MrElliwood/iceduino/docs/iceduino_front_raytraced.png

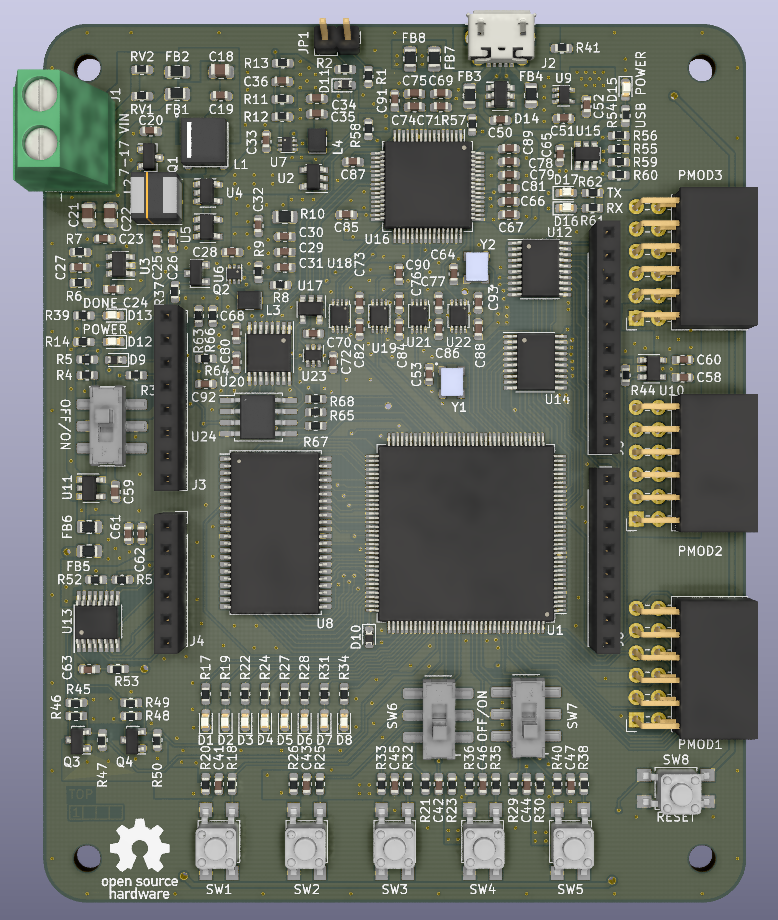
docs/iceduino_front_raytraced.png
