MrElliwood/iceduino/docs/iceduino_iso.png

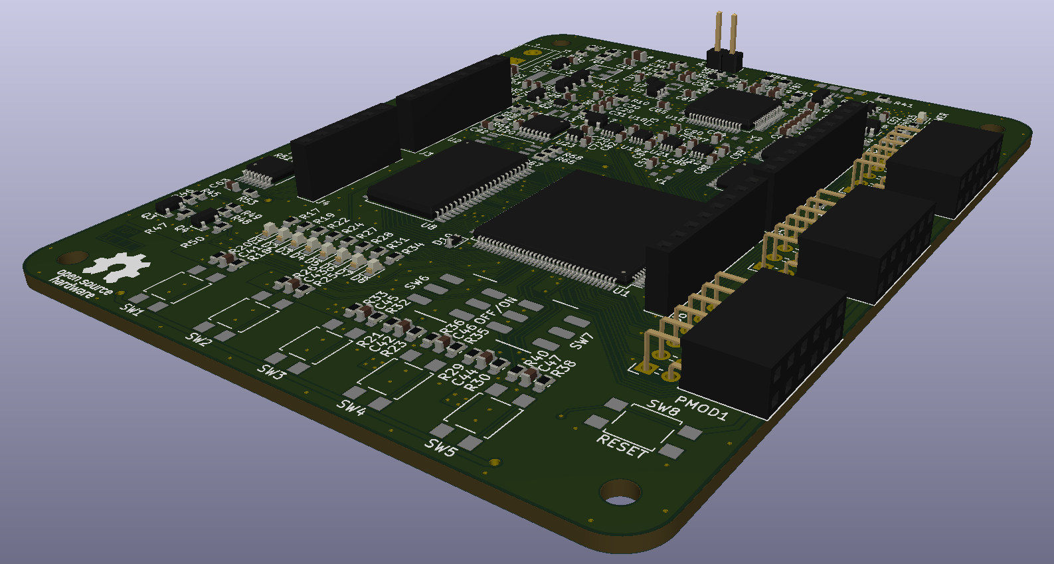
docs/iceduino_iso.png
