MrElliwood/iceduino/docs/iceduino_back.png

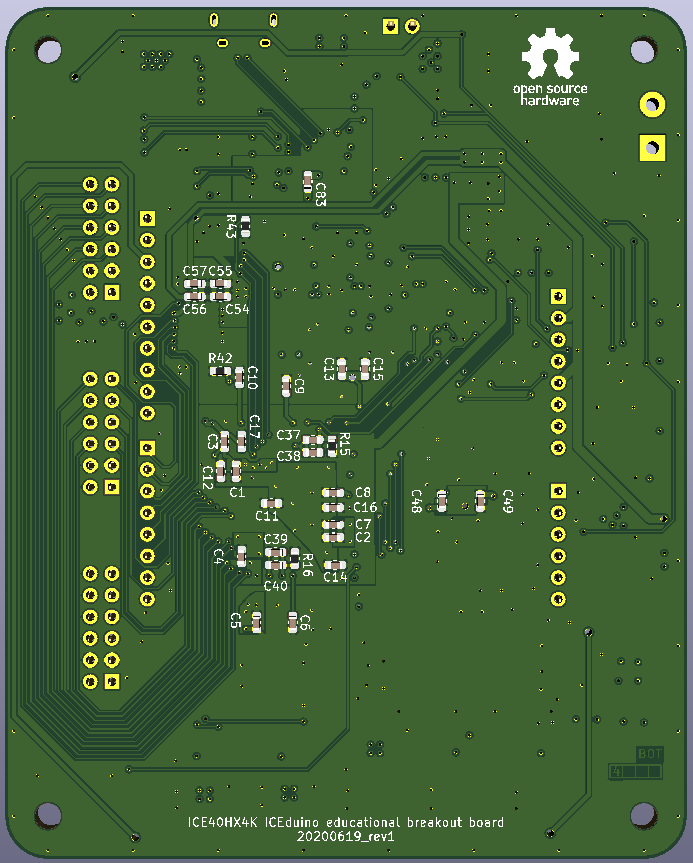
docs/iceduino_back.png
