MrElliwood/iceduino/docs/iceduino_front.png

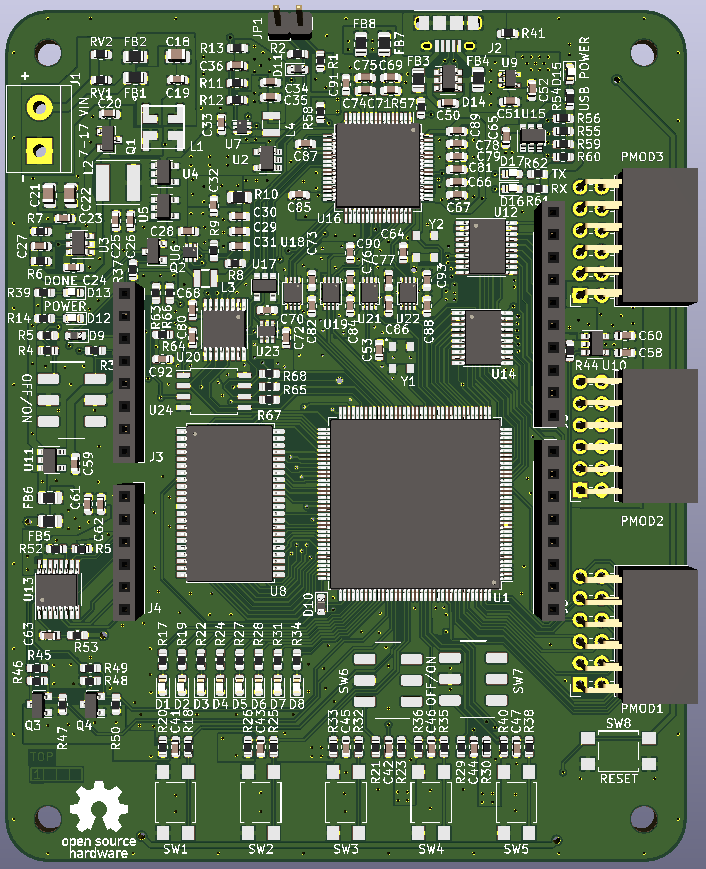
docs/iceduino_front.png
