MrElliwood/iceduino/docs/iceduino-B_SilkS.pdf

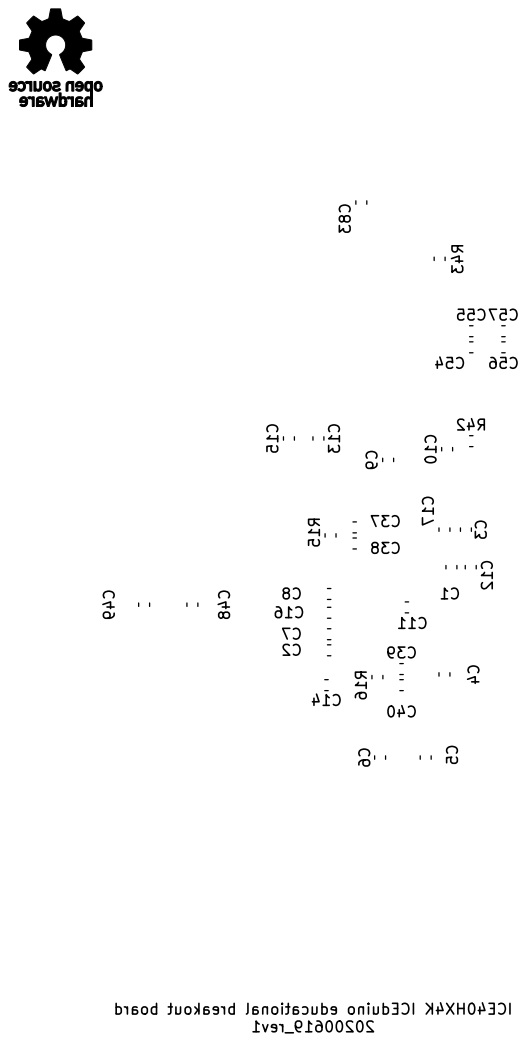
[picture p5: page 1]

ICE40HX4K ICEduino educational breakout board
