MrElliwood/iceduino/docs/iceduino-F_SilkS.pdf

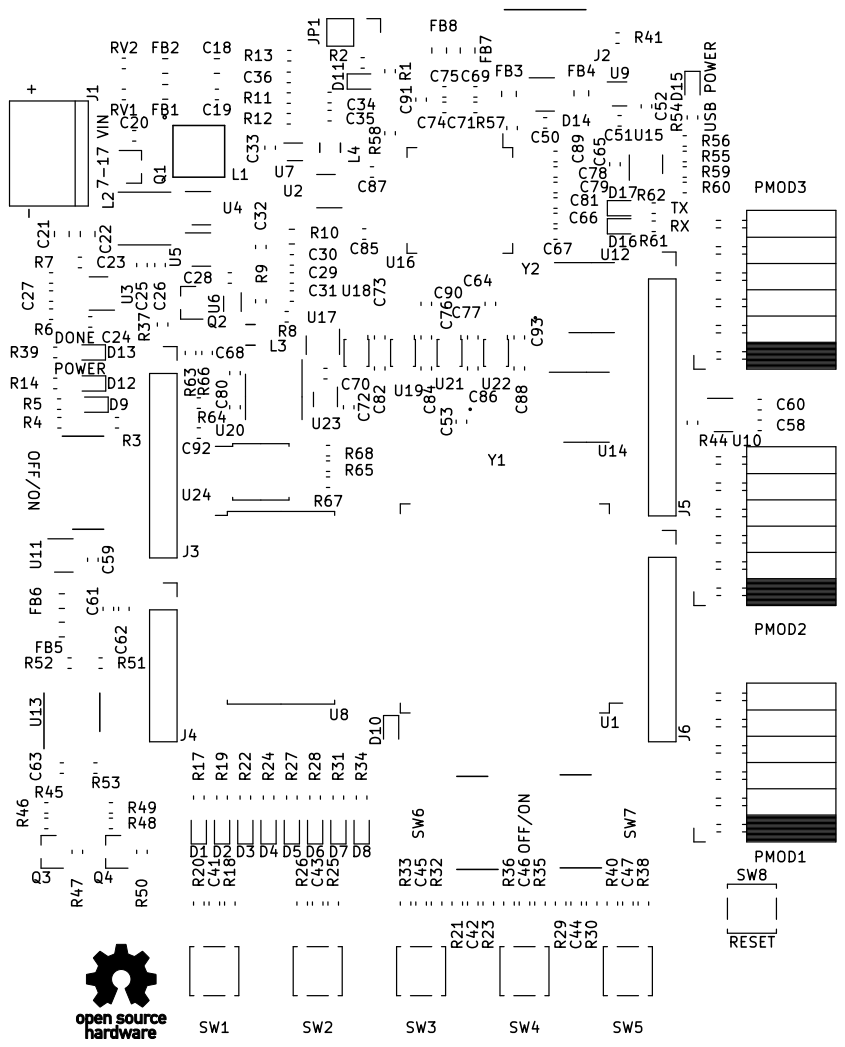
[picture p6: page 1]

OFF/ON USB POWER
RESET RX
