MrElliwood/iceduino/docs/iceduino-B_Cu.pdf

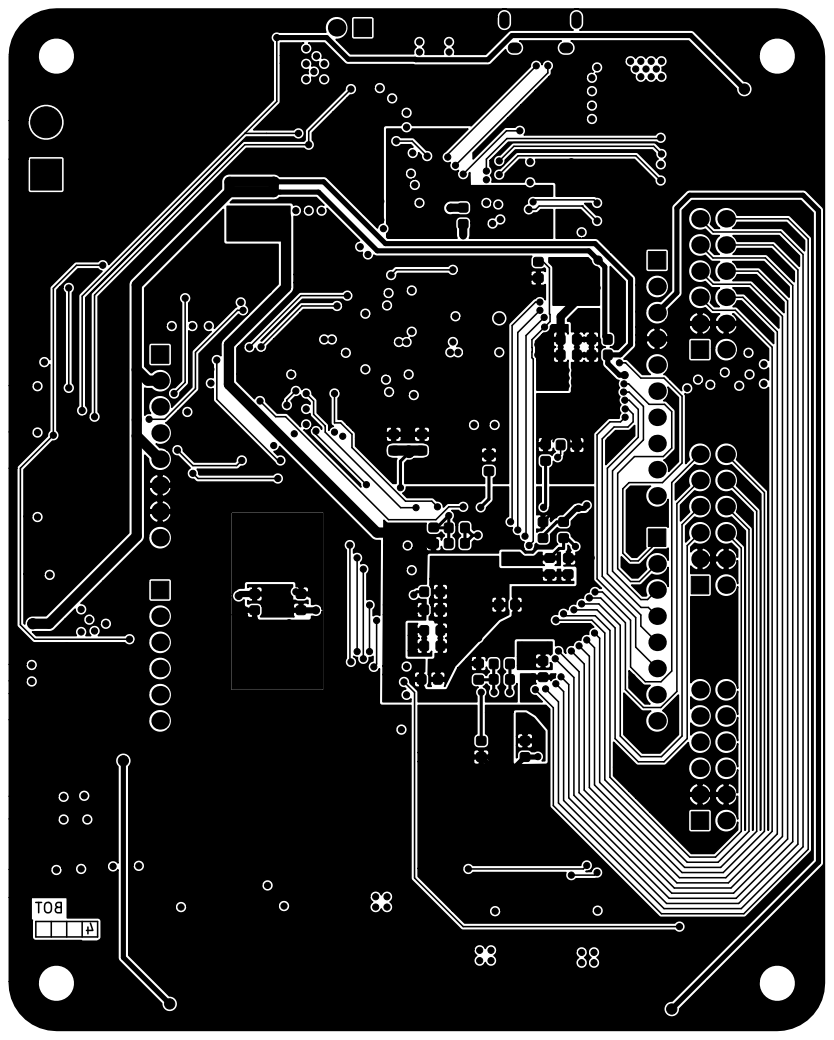
[picture p21: page 1]
