MrElliwood/iceduino/docs/iceduino-F_Cu.pdf

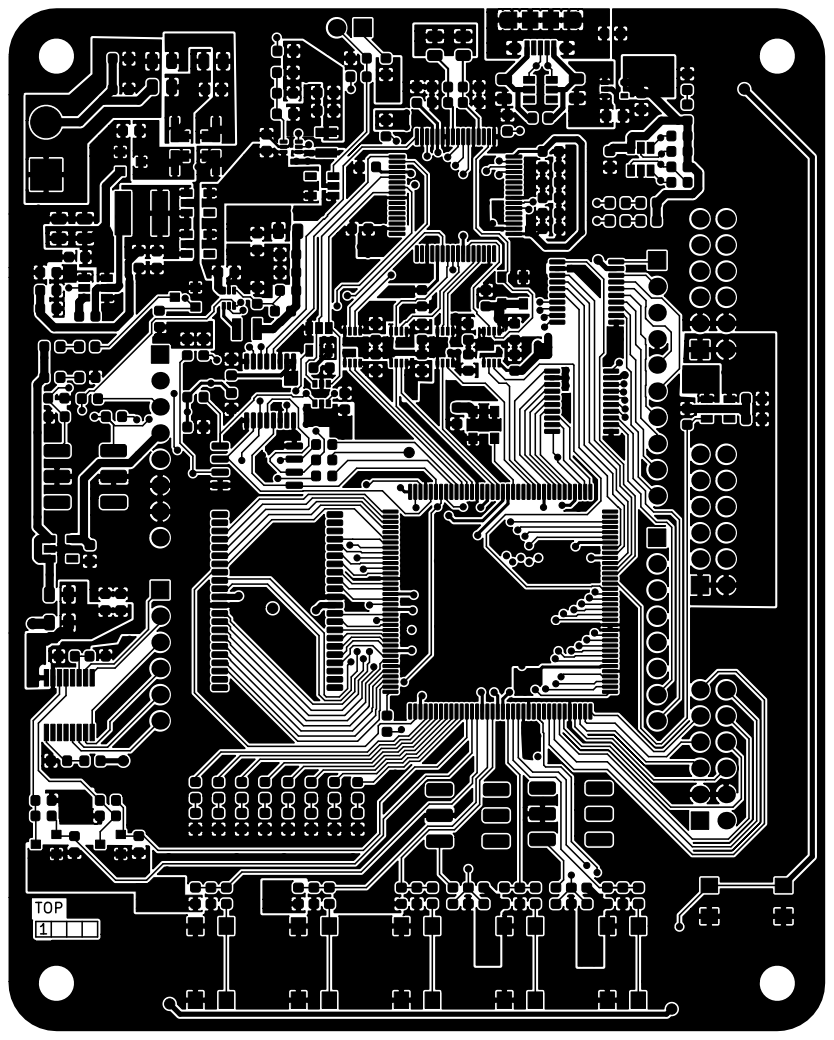
[picture p22: page 1]
