MrElliwood/iceduino/docs/iceduino-In1_Cu.pdf

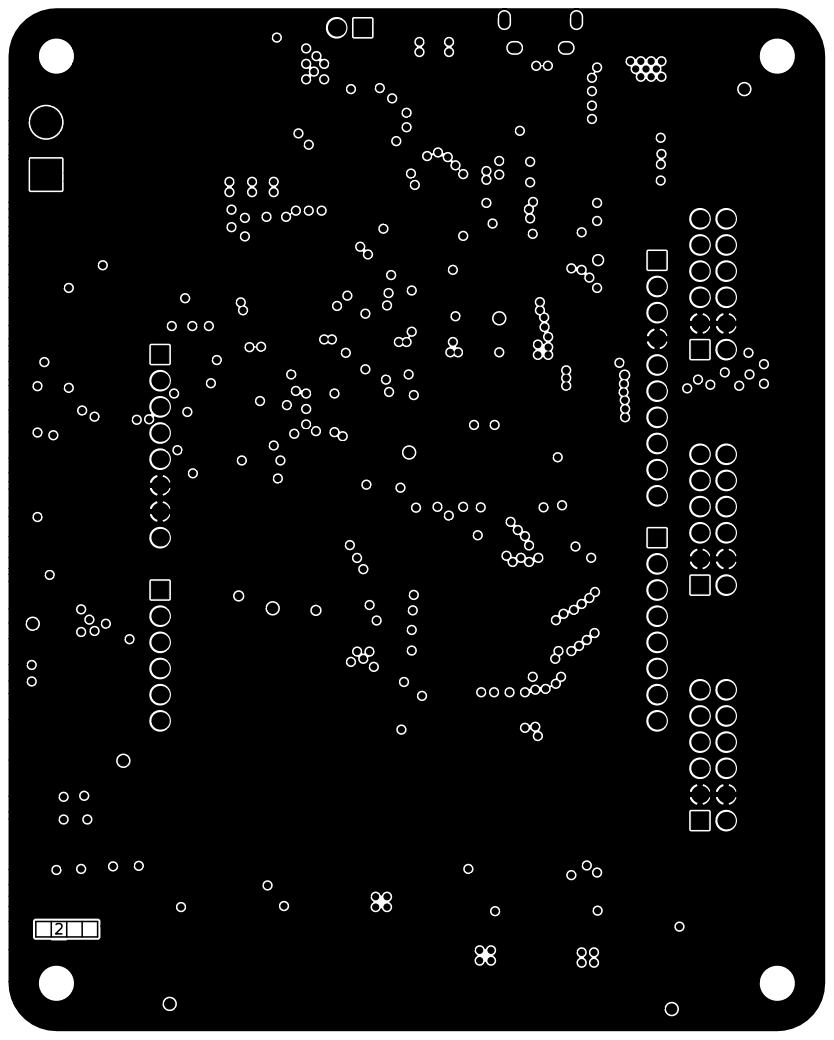
[picture p23: page 1]
