MrElliwood/iceduino/docs/iceduino-In2_Cu.pdf

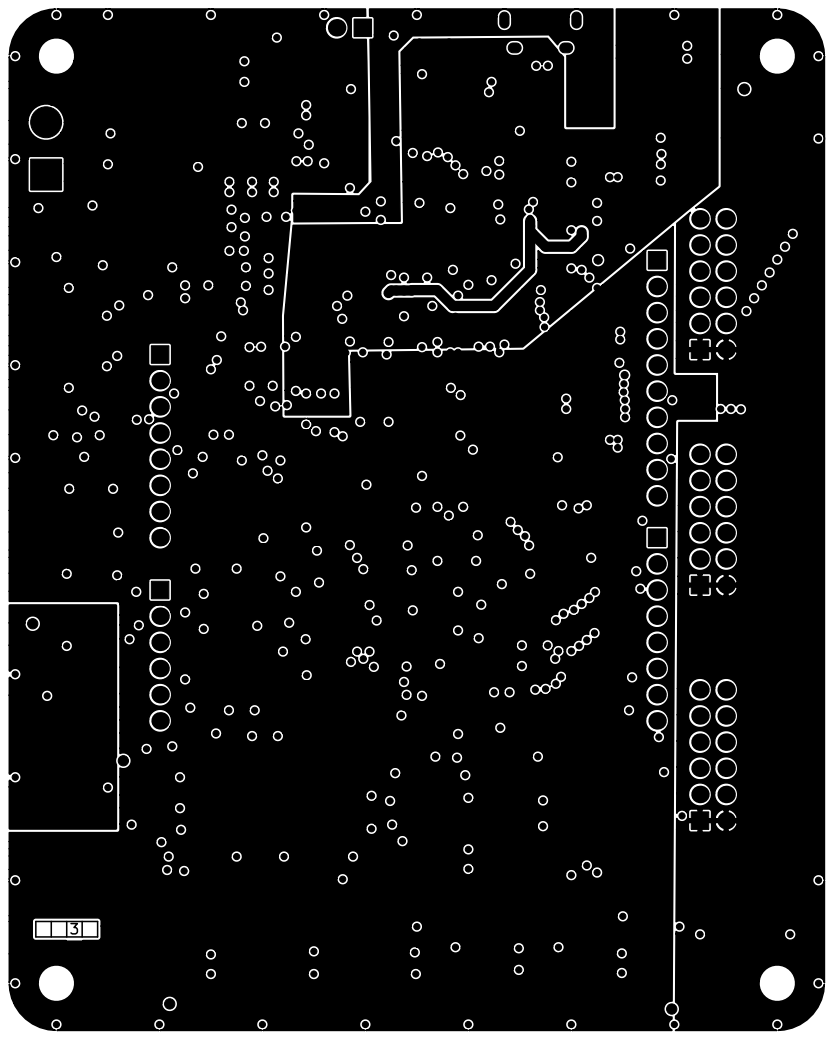
[picture p24: page 1]
