MrElliwood/iceduino/iceduino.kicad_pcb

## KiCad design iceduino.kicad_pcb (2020-06-19)

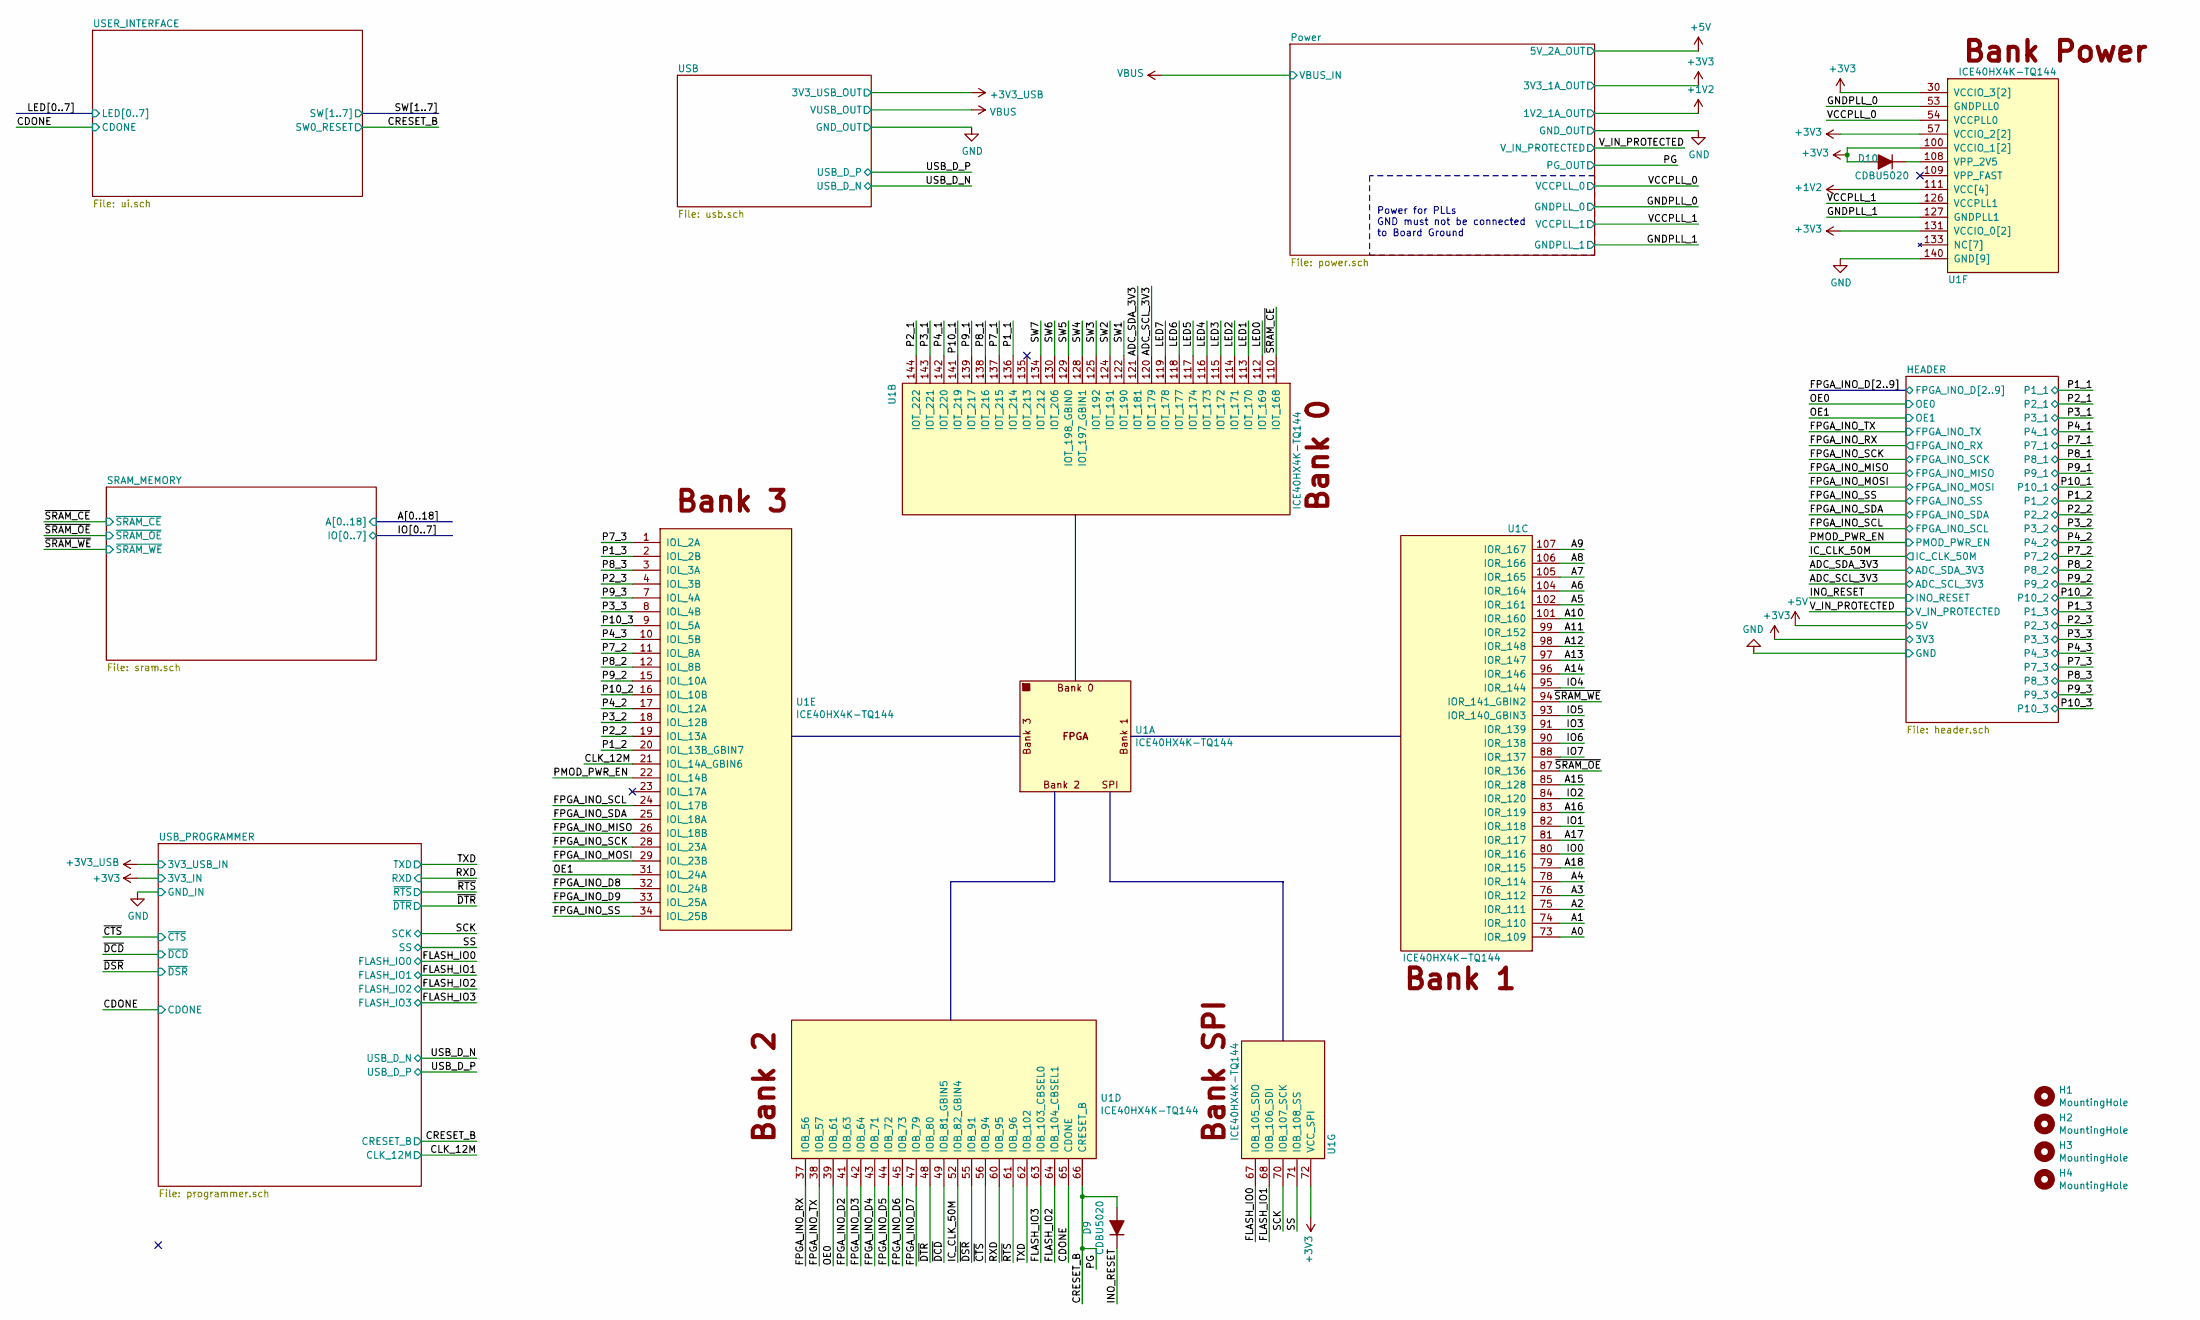
[picture p25: schematic iceduino.sch, ICE40HX4K ICEduino educational breakout board]

Parts:
D9, D10: CDBU5020; D_0603_1608Metric; Mfg Part Num CDBU0520; Digikey 641-1332-1-ND
H1, H2, H3, H4: MountingHole; MountingHole_3mm
U1: ICE40HX4K-TQ144; TQFP-144_20x20mm_P0.5mm; Mfg Part Num ICE40HX4K-TQ144; Digikey 220-1572-ND

Connections:
+1V2: U1.27 (VCC), U1.40 (VCC), U1.92 (VCC), U1.111 (VCC[4]); also elsewhere on the board
+3V3: D10.2 (A), U1.6 (VCCIO_3), U1.30 (VCCIO_3[2]), U1.46 (VCCIO_2), U1.57 (VCCIO_2[2]), U1.72 (VCC_SPI), U1.89 (VCCIO_1), U1.100 (VCCIO_1[2]), U1.123 (VCCIO_0), U1.131 (VCCIO_0[2]); also elsewhere on the board
/A0: U1.73 (IOR_109); also elsewhere on the board
/A1: U1.74 (IOR_110); also elsewhere on the board
/A2: U1.75 (IOR_111); also elsewhere on the board
/A3: U1.76 (IOR_112); also elsewhere on the board
/A4: U1.78 (IOR_114); also elsewhere on the board
/A5: U1.102 (IOR_161); also elsewhere on the board
/A6: U1.104 (IOR_164); also elsewhere on the board
/A7: U1.105 (IOR_165); also elsewhere on the board
/A8: U1.106 (IOR_166); also elsewhere on the board
/A9: U1.107 (IOR_167); also elsewhere on the board
/A10: U1.101 (IOR_160); also elsewhere on the board
/A11: U1.99 (IOR_152); also elsewhere on the board
/A12: U1.98 (IOR_148); also elsewhere on the board
/A13: U1.97 (IOR_147); also elsewhere on the board
/A14: U1.96 (IOR_146); also elsewhere on the board
/A15: U1.85 (IOR_128); also elsewhere on the board
/A16: U1.83 (IOR_119); also elsewhere on the board
/A17: U1.81 (IOR_117); also elsewhere on the board
/A18: U1.79 (IOR_115); also elsewhere on the board
/ADC_SCL_3V3: U1.120 (IOT_179); also elsewhere on the board
/ADC_SDA_3V3: U1.121 (IOT_181); also elsewhere on the board
/CDONE: U1.65 (CDONE); also elsewhere on the board
/CLK_12M: U1.21 (IOL_14A_GBIN6); also elsewhere on the board
/CRESET_B: D9.2 (A), U1.66 (CRESET_B); also elsewhere on the board
/FLASH_IO0: U1.67 (IOB_105_SDO); also elsewhere on the board
/FLASH_IO1: U1.68 (IOB_106_SDI); also elsewhere on the board
/FLASH_IO2: U1.64 (IOB_104_CBSEL1); also elsewhere on the board
/FLASH_IO3: U1.63 (IOB_103_CBSEL0); also elsewhere on the board
/FPGA_INO_D2: U1.41 (IOB_63); also elsewhere on the board
/FPGA_INO_D3: U1.42 (IOB_64); also elsewhere on the board
/FPGA_INO_D4: U1.43 (IOB_71); also elsewhere on the board
/FPGA_INO_D5: U1.44 (IOB_72); also elsewhere on the board
/FPGA_INO_D6: U1.45 (IOB_73); also elsewhere on the board
/FPGA_INO_D7: U1.47 (IOB_79); also elsewhere on the board
/FPGA_INO_D8: U1.32 (IOL_24B); also elsewhere on the board
/FPGA_INO_D9: U1.33 (IOL_25A); also elsewhere on the board
/FPGA_INO_MISO: U1.26 (IOL_18B); also elsewhere on the board
/FPGA_INO_MOSI: U1.29 (IOL_23B); also elsewhere on the board
/FPGA_INO_RX: U1.37 (IOB_56); also elsewhere on the board
/FPGA_INO_SCK: U1.28 (IOL_23A); also elsewhere on the board
/FPGA_INO_SCL: U1.24 (IOL_17B); also elsewhere on the board
/FPGA_INO_SDA: U1.25 (IOL_18A); also elsewhere on the board
/FPGA_INO_SS: U1.34 (IOL_25B); also elsewhere on the board
/FPGA_INO_TX: U1.38 (IOB_57); also elsewhere on the board
/GNDPLL_0: U1.53 (GNDPLL0); also elsewhere on the board
/GNDPLL_1: U1.127 (GNDPLL1); also elsewhere on the board
/IC_CLK_50M: U1.52 (IOB_82_GBIN4); also elsewhere on the board
/INO_RESET: D9.1 (K); also elsewhere on the board
/IO0: U1.80 (IOR_116); also elsewhere on the board
/IO1: U1.82 (IOR_118); also elsewhere on the board
/IO2: U1.84 (IOR_120); also elsewhere on the board
/IO3: U1.91 (IOR_139); also elsewhere on the board
/IO4: U1.95 (IOR_144); also elsewhere on the board
/IO5: U1.93 (IOR_140_GBIN3); also elsewhere on the board
/IO6: U1.90 (IOR_138); also elsewhere on the board
/IO7: U1.88 (IOR_137); also elsewhere on the board
/LED0: U1.112 (IOT_169); also elsewhere on the board
/LED1: U1.113 (IOT_170); also elsewhere on the board
/LED2: U1.114 (IOT_171); also elsewhere on the board
/LED3: U1.115 (IOT_172); also elsewhere on the board
/LED4: U1.116 (IOT_173); also elsewhere on the board
/LED5: U1.117 (IOT_174); also elsewhere on the board
/LED6: U1.118 (IOT_177); also elsewhere on the board
/LED7: U1.119 (IOT_178); also elsewhere on the board
/OE0: U1.39 (IOB_61); also elsewhere on the board
/OE1: U1.31 (IOL_24A); also elsewhere on the board
/P1_1: U1.136 (IOT_214); also elsewhere on the board
/P1_2: U1.20 (IOL_13B_GBIN7); also elsewhere on the board
/P1_3: U1.2 (IOL_2B); also elsewhere on the board
/P2_1: U1.144 (IOT_222); also elsewhere on the board
/P2_2: U1.19 (IOL_13A); also elsewhere on the board
/P2_3: U1.4 (IOL_3B); also elsewhere on the board
/P3_1: U1.143 (IOT_221); also elsewhere on the board
/P3_2: U1.18 (IOL_12B); also elsewhere on the board
/P3_3: U1.8 (IOL_4B); also elsewhere on the board
/P4_1: U1.142 (IOT_220); also elsewhere on the board
/P4_2: U1.17 (IOL_12A); also elsewhere on the board
/P4_3: U1.10 (IOL_5B); also elsewhere on the board
/P7_1: U1.137 (IOT_215); also elsewhere on the board
/P7_2: U1.11 (IOL_8A); also elsewhere on the board
/P7_3: U1.1 (IOL_2A); also elsewhere on the board
/P8_1: U1.138 (IOT_216); also elsewhere on the board
/P8_2: U1.12 (IOL_8B); also elsewhere on the board
/P8_3: U1.3 (IOL_3A); also elsewhere on the board
/P9_1: U1.139 (IOT_217); also elsewhere on the board
/P9_2: U1.15 (IOL_10A); also elsewhere on the board
/P9_3: U1.7 (IOL_4A); also elsewhere on the board
/P10_1: U1.141 (IOT_219); also elsewhere on the board
/P10_2: U1.16 (IOL_10B); also elsewhere on the board
/P10_3: U1.9 (IOL_5A); also elsewhere on the board
/PMOD_PWR_EN: U1.22 (IOL_14B); also elsewhere on the board
/RXD: U1.60 (IOB_95); also elsewhere on the board
/SCK: U1.70 (IOB_107_SCK); also elsewhere on the board
/SS: U1.71 (IOB_108_SS); also elsewhere on the board
/SW1: U1.122 (IOT_190); also elsewhere on the board
/SW2: U1.124 (IOT_191); also elsewhere on the board
/SW3: U1.125 (IOT_192); also elsewhere on the board
/SW4: U1.128 (IOT_197_GBIN1); also elsewhere on the board
/SW5: U1.129 (IOT_198_GBIN0); also elsewhere on the board
/SW6: U1.130 (IOT_206); also elsewhere on the board
/SW7: U1.134 (IOT_212); also elsewhere on the board
/TXD: U1.62 (IOB_102); also elsewhere on the board
/VCCPLL_0: U1.54 (VCCPLL0); also elsewhere on the board
/VCCPLL_1: U1.126 (VCCPLL1); also elsewhere on the board
/~CTS~: U1.56 (IOB_94); also elsewhere on the board
/~DCD~: U1.49 (IOB_81_GBIN5); also elsewhere on the board
/~DSR~: U1.55 (IOB_91); also elsewhere on the board
/~DTR~: U1.48 (IOB_80); also elsewhere on the board
/~RTS~: U1.61 (IOB_96); also elsewhere on the board
/~SRAM_CE~: U1.110 (IOT_168); also elsewhere on the board
/~SRAM_OE~: U1.87 (IOR_136); also elsewhere on the board
/~SRAM_WE~: U1.94 (IOR_141_GBIN2); also elsewhere on the board
GND: U1.5 (GND), U1.13 (GND), U1.14 (GND), U1.59 (GND), U1.69 (GND), U1.86 (GND), U1.103 (GND), U1.132 (GND), U1.140 (GND[9]); also elsewhere on the board
unnamed: D10.1 (K), U1.108 (VPP_2V5)
unnamed: U1.35 (NC), U1.36 (NC), U1.50 (NC), U1.51 (NC), U1.58 (NC), U1.77 (NC), U1.133 (NC[7])

Notes on the sheet:
Power for PLLs GND must not be connected to Board Ground

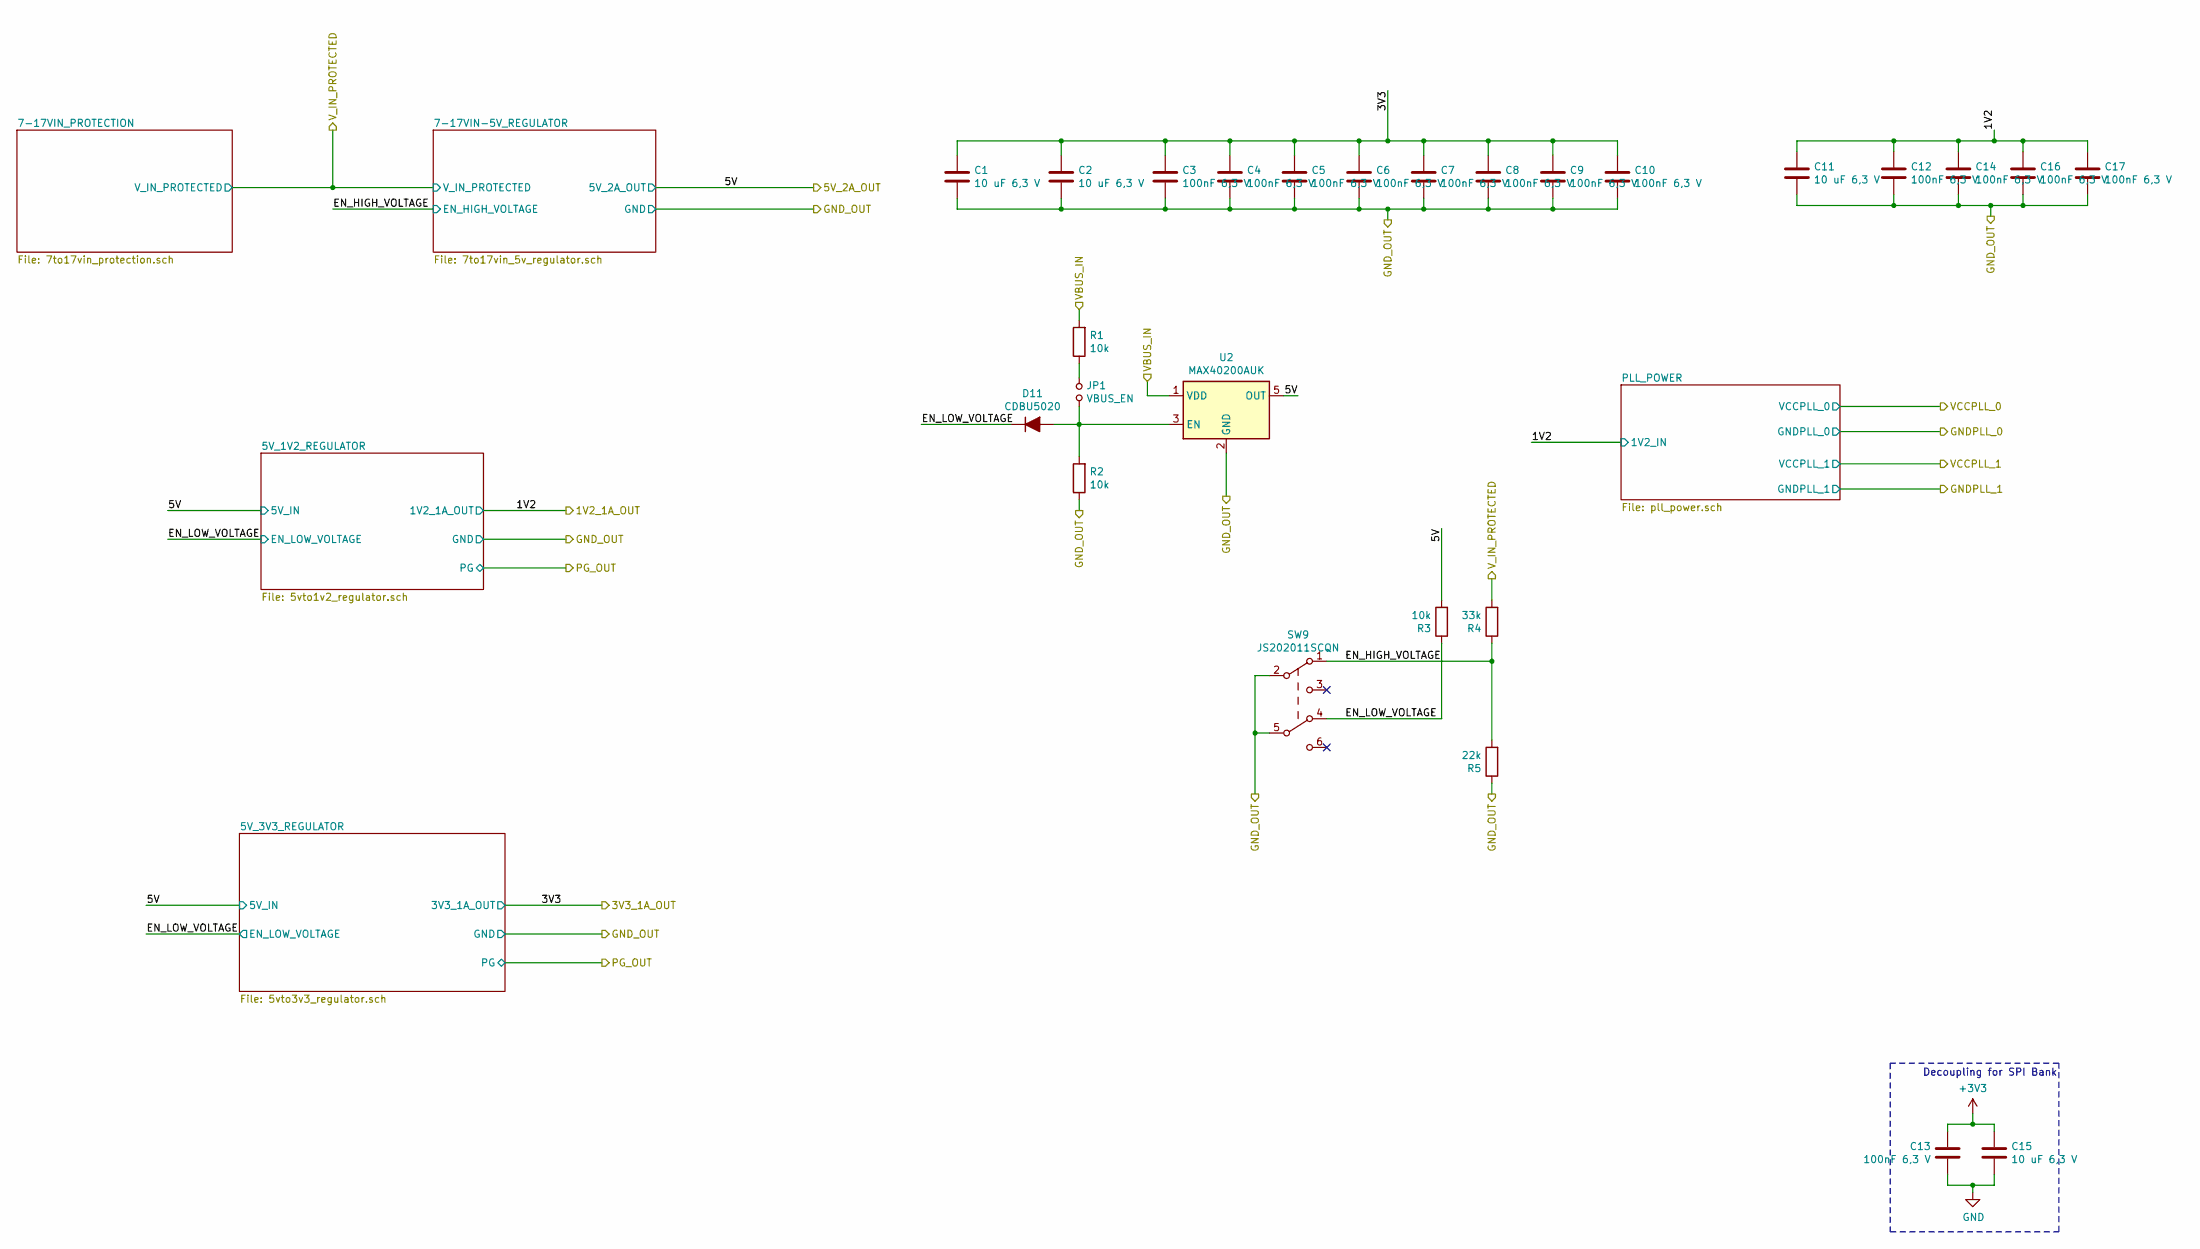
[picture p26: schematic power.sch, ICE40HX4K ICEduino educational breakout board]

Parts:
C1, C2, C11, C15: 10 uF 6,3 V; C_0603_1608Metric; Mfg Part Num CL10A106MQ8NNNC; Digikey 1276-1119-1-ND
C3, C4, C5, C6, C7, C8, C9, C10, C12, C13, C14, C16, C17: 100nF 6,3 V; C_0603_1608Metric; Mfg Part Num CL10B104KB8NNNC; Digikey 1276-1000-1-ND
D11: CDBU5020; D_0603_1608Metric; Mfg Part Num CDBU0520; Digikey 641-1332-1-ND
JP1: VBUS_EN; PinHeader_1x02_P2.54mm_Vertical
R1, R2, R3: 10k; R_0603_1608Metric; Mfg Part Num RMCF0603JT10K0; Digikey RMCF0603JT10K0CT-ND
R4: 33k; R_0603_1608Metric; Mfg Part Num RC0603JR-0733KL; Digikey 311-33KGRCT-ND
R5: 22k; R_0603_1608Metric; Mfg Part Num RC0603FR-0722KL; Digikey 311-22.0KHRCT-ND
SW9: JS202011SCQN; SW_SLIDE_DPDT_Slide_CK_JS202011SCQN_W3mm_P2.5mm_footprint; Mfg Part Num JS202011SCQN; Digikey 401-2002-1-ND
U2: MAX40200AUK; SOT-23-5; Mfg Part Num MAX40200AUK+T; Digikey MAX40200AUK+TCT-ND

Connections:
+1V2: C11.1, C12.1, C14.1, C16.1, C17.1; also elsewhere on the board
+3V3: C1.1, C2.1, C3.1, C4.1, C5.1, C6.1, C7.1, C8.1, C9.1, C10.1, C13.1, C15.1; also elsewhere on the board
+5V: R3.2, U2.5 (OUT); also elsewhere on the board
/Power/EN_HIGH_VOLTAGE: R4.1, R5.2, SW9.1 (A); also elsewhere on the board
/Power/EN_LOW_VOLTAGE: D11.1 (K), R3.1, SW9.4 (A); also elsewhere on the board
/V_IN_PROTECTED: R4.2; also elsewhere on the board
GND: C1.2, C2.2, C3.2, C4.2, C5.2, C6.2, C7.2, C8.2, C9.2, C10.2, C11.2, C12.2, C13.2, C14.2, C15.2, C16.2, C17.2, R2.1, R5.1, SW9.2 (B), SW9.5 (B), U2.2 (GND); also elsewhere on the board
unnamed: D11.2 (A), JP1.2, R2.2, U2.3 (EN)
unnamed: JP1.1, R1.1
VBUS: R1.2, U2.1 (VDD); also elsewhere on the board

Notes on the sheet:
Decoupling for SPI Bank

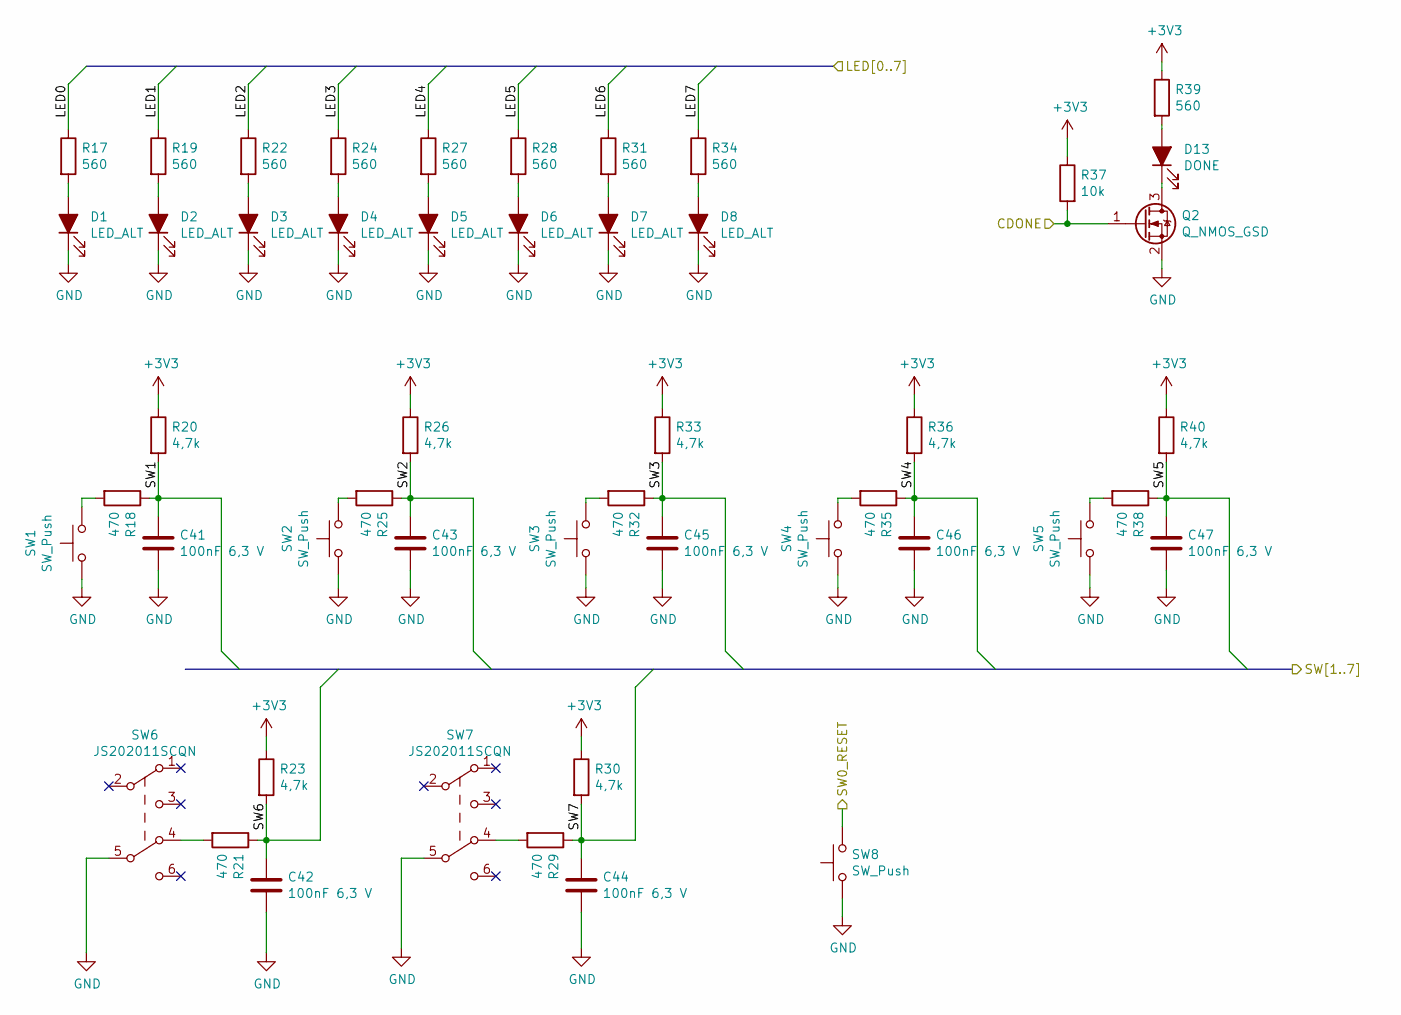
[picture p27: schematic ui.sch, ICE40HX4K ICEduino educational breakout board]

Parts:
C41, C42, C43, C44, C45, C46, C47: 100nF 6,3 V; C_0603_1608Metric; Mfg Part Num CL10B104KB8NNNC; Digikey 1276-1000-1-ND
D1, D2, D3, D4, D5, D6, D7, D8: LED_ALT; LED_0603_1608Metric; Mfg Part Num SML-D12U1WT86; Digikey SML-D12U1WT86CT-ND
D13: DONE; LED_0603_1608Metric; Mfg Part Num SML-D12U1WT86; Digikey SML-D12U1WT86CT-ND
Q2: Q_NMOS_GSD; SOT-23; Mfg Part Num DMN65D8L-7; Digikey DMN65D8L-7DICT-ND
R17, R19, R22, R24, R27, R28, R31, R34, R39: 560; R_0603_1608Metric; Mfg Part Num RK73B1JTTD561J; Digikey 2019-RK73B1JTTD561JCT-ND
R18, R21, R25, R29, R32, R35, R38: 470; R_0603_1608Metric; Mfg Part Num RMCF0603JT470R; Digikey RMCF0603JT470RCT-ND
R20, R23, R26, R30, R33, R36, R40: 4,7k; R_0603_1608Metric; Mfg Part Num RMCF0603JT4K70; Digikey RMCF0603JT4K70CT-ND
R37: 10k; R_0603_1608Metric; Mfg Part Num RMCF0603JT10K0; Digikey RMCF0603JT10K0CT-ND
SW1, SW2, SW3, SW4, SW5, SW8: SW_Push; SW_SPST_TL3305A; Mfg Part Num TL3305AF160QG; Digikey EG5350CT-ND
SW6, SW7: JS202011SCQN; SW_SLIDE_DPDT_Slide_CK_JS202011SCQN_W3mm_P2.5mm_footprint; Mfg Part Num JS202011SCQN; Digikey 401-2002-1-ND

Connections:
+3V3: R20.1, R23.1, R26.1, R30.1, R33.1, R36.1, R37.1, R39.1, R40.1; also elsewhere on the board
/CDONE: Q2.1 (G), R37.2; also elsewhere on the board
/CRESET_B: SW8.2; also elsewhere on the board
/LED0: R17.1; also elsewhere on the board
/LED1: R19.1; also elsewhere on the board
/LED2: R22.1; also elsewhere on the board
/LED3: R24.1; also elsewhere on the board
/LED4: R27.1; also elsewhere on the board
/LED5: R28.1; also elsewhere on the board
/LED6: R31.1; also elsewhere on the board
/LED7: R34.1; also elsewhere on the board
/SW1: C41.1, R18.1, R20.2; also elsewhere on the board
/SW2: C43.1, R25.1, R26.2; also elsewhere on the board
/SW3: C45.1, R32.1, R33.2; also elsewhere on the board
/SW4: C46.1, R35.1, R36.2; also elsewhere on the board
/SW5: C47.1, R38.1, R40.2; also elsewhere on the board
/SW6: C42.1, R21.1, R23.2; also elsewhere on the board
/SW7: C44.1, R29.1, R30.2; also elsewhere on the board
GND: C41.2, C42.2, C43.2, C44.2, C45.2, C46.2, C47.2, D1.1 (K), D2.1 (K), D3.1 (K), D4.1 (K), D5.1 (K), D6.1 (K), D7.1 (K), D8.1 (K), Q2.2 (S), SW1.1, SW2.1, SW3.1, SW4.1, SW5.1, SW6.5 (B), SW7.5 (B), SW8.1; also elsewhere on the board
unnamed: D1.2 (A), R17.2
unnamed: D2.2 (A), R19.2
unnamed: D3.2 (A), R22.2
unnamed: D4.2 (A), R24.2
unnamed: D5.2 (A), R27.2
unnamed: D6.2 (A), R28.2
unnamed: D7.2 (A), R31.2
unnamed: D8.2 (A), R34.2
unnamed: D13.1 (K), Q2.3 (D)
unnamed: D13.2 (A), R39.2
unnamed: R18.2, SW1.2
unnamed: R21.2, SW6.4 (A)
unnamed: R25.2, SW2.2
unnamed: R29.2, SW7.4 (A)
unnamed: R32.2, SW3.2
unnamed: R35.2, SW4.2
unnamed: R38.2, SW5.2

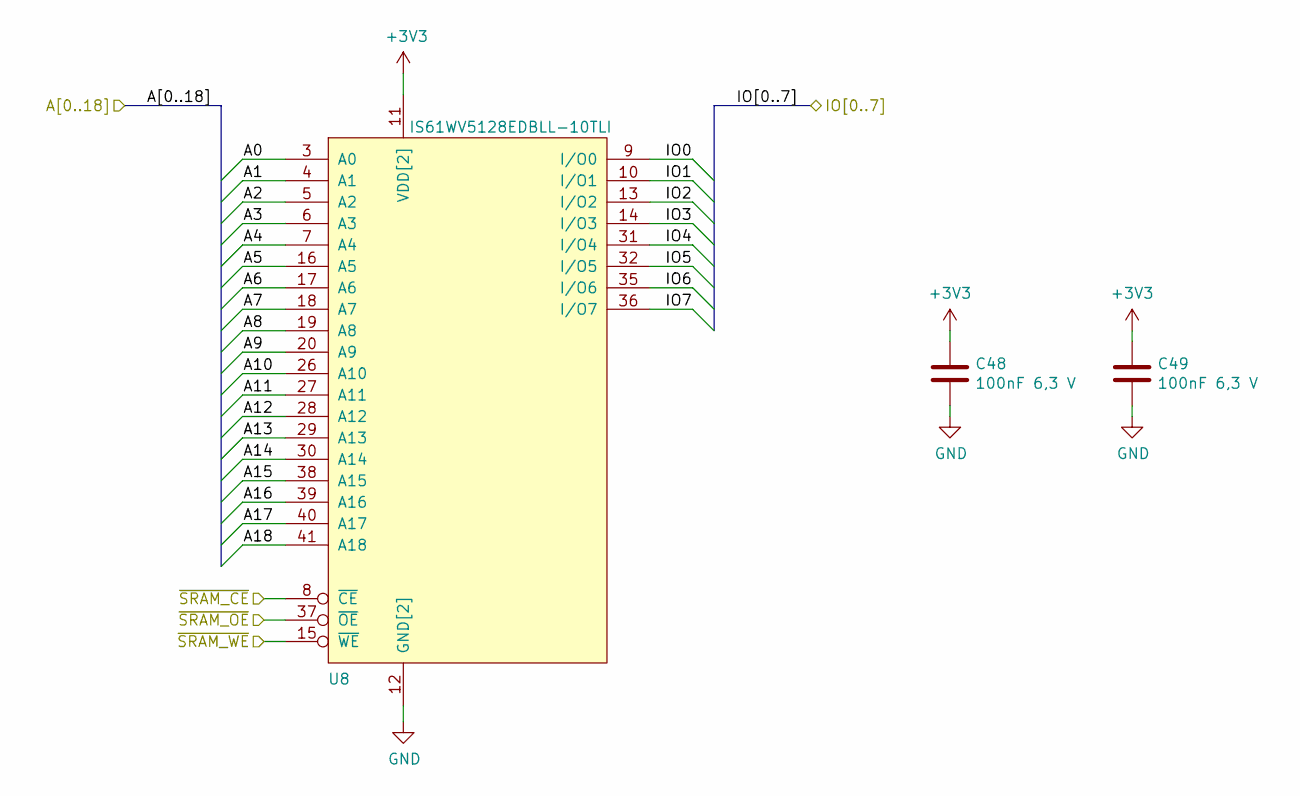
[picture p28: schematic sram.sch, ICE40HX4K ICEduino educational breakout board]

Parts:
C48, C49: 100nF 6,3 V; C_0603_1608Metric; Mfg Part Num CL10B104KB8NNNC; Digikey 1276-1000-1-ND
U8: IS61WV5128EDBLL-10TLI; TSOP-II-44_10.16x18.41mm_P0.8mm; Mfg Part Num IS61WV5128EDBLL-10TLI; Digikey 706-1147-ND

Connections:
+3V3: C48.1, C49.1, U8.11 (VDD[2]), U8.33 (VDD); also elsewhere on the board
/A0: U8.3 (A0); also elsewhere on the board
/A1: U8.4 (A1); also elsewhere on the board
/A2: U8.5 (A2); also elsewhere on the board
/A3: U8.6 (A3); also elsewhere on the board
/A4: U8.7 (A4); also elsewhere on the board
/A5: U8.16 (A5); also elsewhere on the board
/A6: U8.17 (A6); also elsewhere on the board
/A7: U8.18 (A7); also elsewhere on the board
/A8: U8.19 (A8); also elsewhere on the board
/A9: U8.20 (A9); also elsewhere on the board
/A10: U8.26 (A10); also elsewhere on the board
/A11: U8.27 (A11); also elsewhere on the board
/A12: U8.28 (A12); also elsewhere on the board
/A13: U8.29 (A13); also elsewhere on the board
/A14: U8.30 (A14); also elsewhere on the board
/A15: U8.38 (A15); also elsewhere on the board
/A16: U8.39 (A16); also elsewhere on the board
/A17: U8.40 (A17); also elsewhere on the board
/A18: U8.41 (A18); also elsewhere on the board
/IO0: U8.9 (I/O0); also elsewhere on the board
/IO1: U8.10 (I/O1); also elsewhere on the board
/IO2: U8.13 (I/O2); also elsewhere on the board
/IO3: U8.14 (I/O3); also elsewhere on the board
/IO4: U8.31 (I/O4); also elsewhere on the board
/IO5: U8.32 (I/O5); also elsewhere on the board
/IO6: U8.35 (I/O6); also elsewhere on the board
/IO7: U8.36 (I/O7); also elsewhere on the board
/~SRAM_CE~: U8.8 (~CE~); also elsewhere on the board
/~SRAM_OE~: U8.37 (~OE~); also elsewhere on the board
/~SRAM_WE~: U8.15 (~WE~); also elsewhere on the board
GND: C48.2, C49.2, U8.12 (GND[2]), U8.34 (GND); also elsewhere on the board

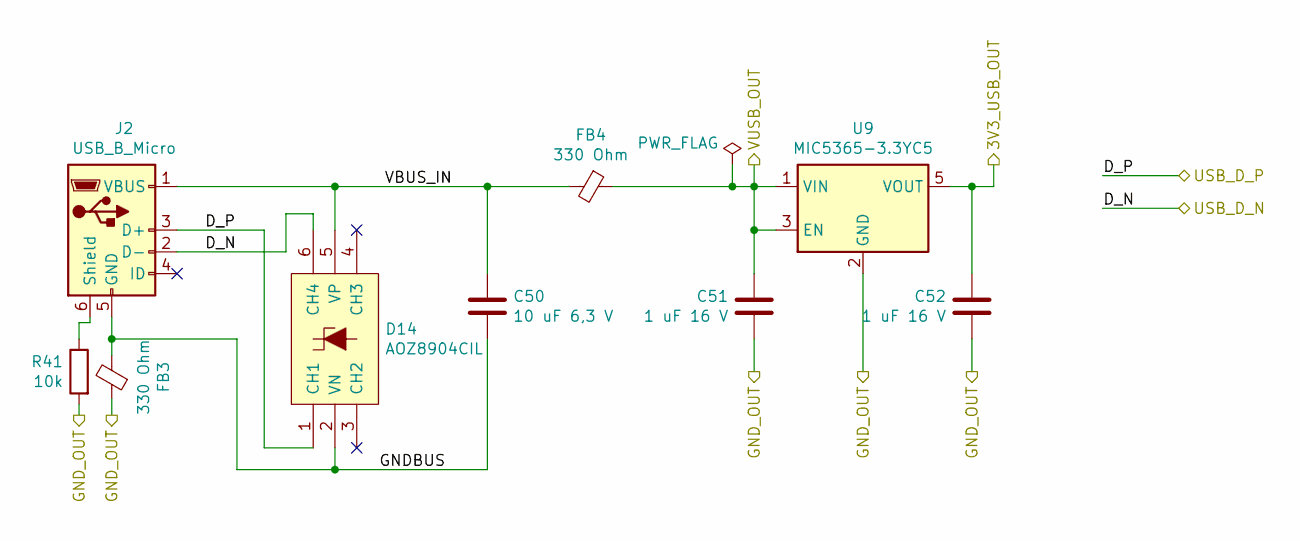
[picture p29: schematic usb.sch, ICE40HX4K ICEduino educational breakout board]

Parts:
C50: 10 uF 6,3 V; C_0603_1608Metric; Mfg Part Num CL10A106MQ8NNNC; Digikey 1276-1119-1-ND
C51, C52: 1 uF 16 V; C_0603_1608Metric; Mfg Part Num CL10B105MO8NNWC; Digikey 1276-6524-1-ND
D14: AOZ8904CIL; SOT-23-6; Mfg Part Num AOZ8904CIL; Digikey 785-1755-1-ND
FB3, FB4: 330 Ohm; R_0805_2012Metric; Mfg Part Num MPZ2012S331AT000; Digikey 445-1569-1-ND
J2: USB_B_Micro; Amphenol_microUSB_B_footprint; Mfg Part Num 10118194-0001LF; Digikey 609-4618-1-ND
R41: 10k; R_0603_1608Metric; Mfg Part Num RMCF0603JT10K0; Digikey RMCF0603JT10K0CT-ND
U9: MIC5365-3.3YC5; SOT-353_SC-70-5; Mfg Part Num MIC5365-3.3YC5-TR; Digikey 576-3193-1-ND

Connections:
+3V3_FTDI: C52.1, U9.5 (VOUT); also elsewhere on the board
/USB/GNDBUS: C50.2, D14.2 (VN), FB3.2, J2.5 (GND)
/USB/VBUS_IN: C50.1, D14.5 (VP), FB4.2, J2.1 (VBUS)
/USB_D_N: D14.6 (CH4), J2.2 (D-); also elsewhere on the board
/USB_D_P: D14.1 (CH1), J2.3 (D+); also elsewhere on the board
GND: C51.2, C52.2, FB3.1, R41.2, U9.2 (GND); also elsewhere on the board
unnamed: J2.6 (Shield), R41.1
VBUS: C51.1, FB4.1, U9.1 (VIN), U9.3 (EN); also elsewhere on the board

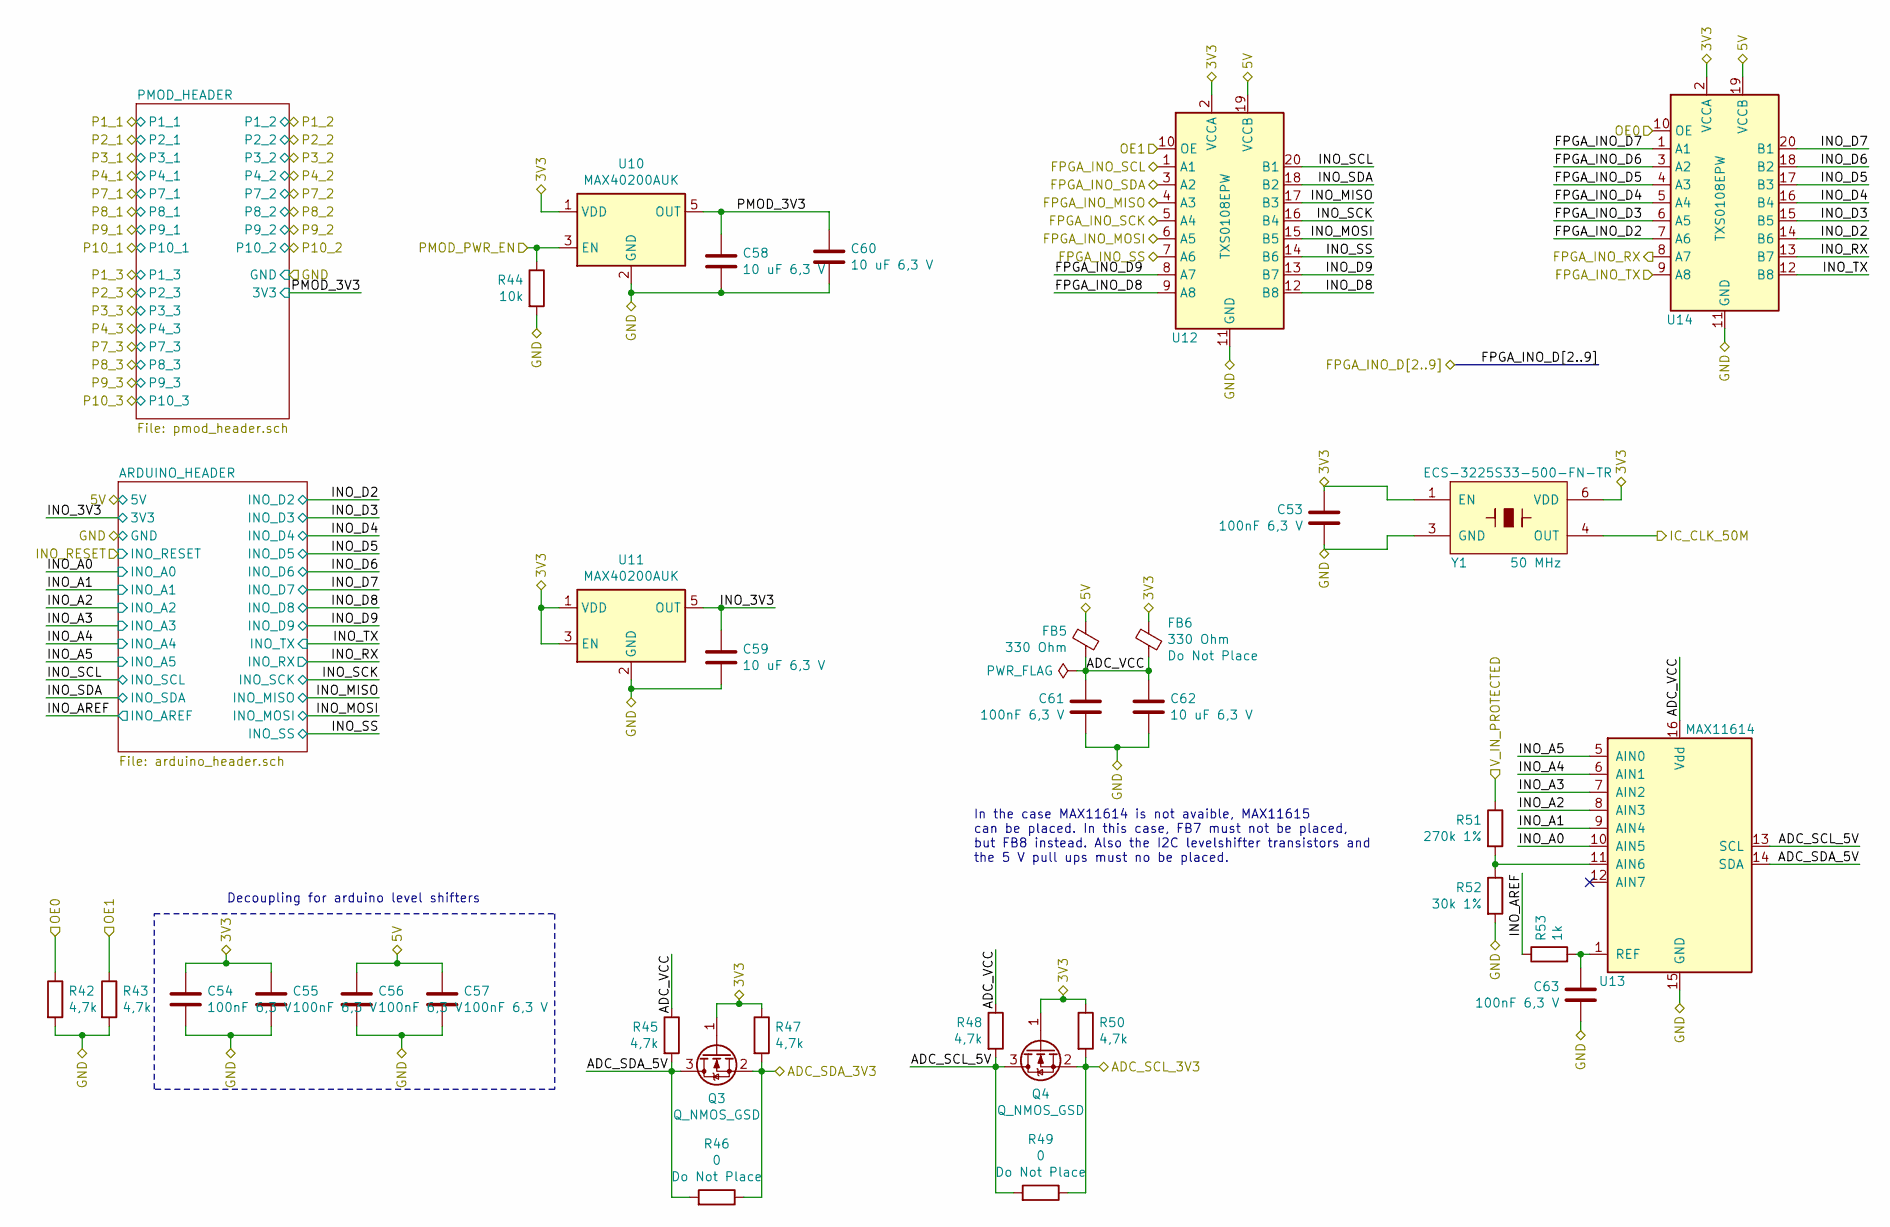
[picture p30: schematic header.sch, ICE40HX4K ICEduino educational breakout board]

Parts:
C53, C54, C55, C56, C57, C61, C63: 100nF 6,3 V; C_0603_1608Metric; Mfg Part Num CL10B104KB8NNNC; Digikey 1276-1000-1-ND
C58, C59, C60, C62: 10 uF 6,3 V; C_0603_1608Metric; Mfg Part Num CL10A106MQ8NNNC; Digikey 1276-1119-1-ND
FB5, FB6: 330 Ohm; R_0805_2012Metric; Mfg Part Num MPZ2012S331AT000; Digikey 445-1569-1-ND
Q3, Q4: Q_NMOS_GSD; SOT-23; Mfg Part Num DMN65D8L-7; Digikey DMN65D8L-7DICT-ND
R42, R43, R45, R47, R48, R50: 4,7k; R_0603_1608Metric; Mfg Part Num RMCF0603JT4K70; Digikey RMCF0603JT4K70CT-ND
R44: 10k; R_0603_1608Metric; Mfg Part Num RMCF0603JT10K0; Digikey RMCF0603JT10K0CT-ND
R46, R49: 0; R_0603_1608Metric
R51: 270k 1%; R_0603_1608Metric; Mfg Part Num RC0603FR-07270KL; Digikey 311-270KHRCT-ND
R52: 30k 1%; R_0603_1608Metric; Mfg Part Num RC0603FR-0730KL; Digikey 311-30.0KHRCT-ND
R53: 1k; R_0603_1608Metric; Mfg Part Num RC0603JR-071KL; Digikey 311-1.0KGRCT-ND
U10, U11: MAX40200AUK; SOT-23-5; Mfg Part Num MAX40200AUK+T; Digikey MAX40200AUK+TCT-ND
U12, U14: TXS0108EPW; TSSOP-20_4.4x6.5mm_P0.65mm; Mfg Part Num TXS0108EPWR; Digikey 296-23011-1-ND
U13: MAX11614; QSOP-16_3.9x4.9mm_P0.635mm; Mfg Part Num MAX11614EEE+; Digikey MAX11614EEE+-ND
Y1: ECS-3225S33-500-FN-TR; Y_ECS-3225S_3.2x2.5mm_footprint; Mfg Part Num ECS-3225S33-500-FN-TR; Digikey XC2226CT-ND

Connections:
+3V3: C53.1, C54.1, C55.1, FB6.2, Q3.1 (G), Q4.1 (G), R47.1, R50.1, U10.1 (VDD), U11.1 (VDD), U11.3 (EN), U12.2 (VCCA), U14.2 (VCCA), Y1.1 (EN), Y1.6 (VDD); also elsewhere on the board
+5V: C56.1, C57.1, FB5.2, U12.19 (VCCB), U14.19 (VCCB); also elsewhere on the board
/ADC_SCL_3V3: Q4.2 (S), R49.1, R50.2; also elsewhere on the board
/ADC_SDA_3V3: Q3.2 (S), R46.1, R47.2; also elsewhere on the board
/FPGA_INO_D2: U14.7 (A6); also elsewhere on the board
/FPGA_INO_D3: U14.6 (A5); also elsewhere on the board
/FPGA_INO_D4: U14.5 (A4); also elsewhere on the board
/FPGA_INO_D5: U14.4 (A3); also elsewhere on the board
/FPGA_INO_D6: U14.3 (A2); also elsewhere on the board
/FPGA_INO_D7: U14.1 (A1); also elsewhere on the board
/FPGA_INO_D8: U12.9 (A8); also elsewhere on the board
/FPGA_INO_D9: U12.8 (A7); also elsewhere on the board
/FPGA_INO_MISO: U12.4 (A3); also elsewhere on the board
/FPGA_INO_MOSI: U12.6 (A5); also elsewhere on the board
/FPGA_INO_RX: U14.8 (A7); also elsewhere on the board
/FPGA_INO_SCK: U12.5 (A4); also elsewhere on the board
/FPGA_INO_SCL: U12.1 (A1); also elsewhere on the board
/FPGA_INO_SDA: U12.3 (A2); also elsewhere on the board
/FPGA_INO_SS: U12.7 (A6); also elsewhere on the board
/FPGA_INO_TX: U14.9 (A8); also elsewhere on the board
/HEADER/ADC_SCL_5V: Q4.3 (D), R48.2, R49.2, U13.13 (SCL)
/HEADER/ADC_SDA_5V: Q3.3 (D), R45.2, R46.2, U13.14 (SDA)
/HEADER/ADC_VCC: C61.1, C62.1, FB5.1, FB6.1, R45.1, R48.1, U13.16 (Vdd)
/HEADER/INO_3V3: C59.1, U11.5 (OUT); also elsewhere on the board
/HEADER/INO_A0: U13.10 (AIN5); also elsewhere on the board
/HEADER/INO_A1: U13.9 (AIN4); also elsewhere on the board
/HEADER/INO_A2: U13.8 (AIN3); also elsewhere on the board
/HEADER/INO_A3: U13.7 (AIN2); also elsewhere on the board
/HEADER/INO_A4: U13.6 (AIN1); also elsewhere on the board
/HEADER/INO_A5: U13.5 (AIN0); also elsewhere on the board
/HEADER/INO_AREF: R53.1; also elsewhere on the board
/HEADER/INO_D2: U14.14 (B6); also elsewhere on the board
/HEADER/INO_D3: U14.15 (B5); also elsewhere on the board
/HEADER/INO_D4: U14.16 (B4); also elsewhere on the board
/HEADER/INO_D5: U14.17 (B3); also elsewhere on the board
/HEADER/INO_D6: U14.18 (B2); also elsewhere on the board
/HEADER/INO_D7: U14.20 (B1); also elsewhere on the board
/HEADER/INO_D8: U12.12 (B8); also elsewhere on the board
/HEADER/INO_D9: U12.13 (B7); also elsewhere on the board
/HEADER/INO_MISO: U12.17 (B3); also elsewhere on the board
/HEADER/INO_MOSI: U12.15 (B5); also elsewhere on the board
/HEADER/INO_RX: U14.13 (B7); also elsewhere on the board
/HEADER/INO_SCK: U12.16 (B4); also elsewhere on the board
/HEADER/INO_SCL: U12.20 (B1); also elsewhere on the board
/HEADER/INO_SDA: U12.18 (B2); also elsewhere on the board
/HEADER/INO_SS: U12.14 (B6); also elsewhere on the board
/HEADER/INO_TX: U14.12 (B8); also elsewhere on the board
/HEADER/PMOD_3V3: C58.1, C60.1, U10.5 (OUT); also elsewhere on the board
/IC_CLK_50M: Y1.4 (OUT); also elsewhere on the board
/OE0: R42.1, U14.10 (OE); also elsewhere on the board
/OE1: R43.1, U12.10 (OE); also elsewhere on the board
/PMOD_PWR_EN: R44.1, U10.3 (EN); also elsewhere on the board
/V_IN_PROTECTED: R51.1; also elsewhere on the board
GND: C53.2, C54.2, C55.2, C56.2, C57.2, C58.2, C59.2, C60.2, C61.2, C62.2, C63.2, R42.2, R43.2, R44.2, R52.2, U10.2 (GND), U11.2 (GND), U12.11 (GND), U13.15 (GND), U14.11 (GND), Y1.3 (GND); also elsewhere on the board
unnamed: C63.1, R53.2, U13.1 (REF)
unnamed: R51.2, R52.1, U13.11 (AIN6)

Notes on the sheet:
In the case MAX11614 is not avaible, MAX11615 can be placed. In this case, FB7 must not be placed, but FB8 instead. Also the I2C levelshifter transistors and the 5 V pull ups must no be placed.
Decoupling for arduino level shifters
