MrElliwood/iceduino/iceduino.kicad_pcb

## KiCad design iceduino.kicad_pcb (continued)

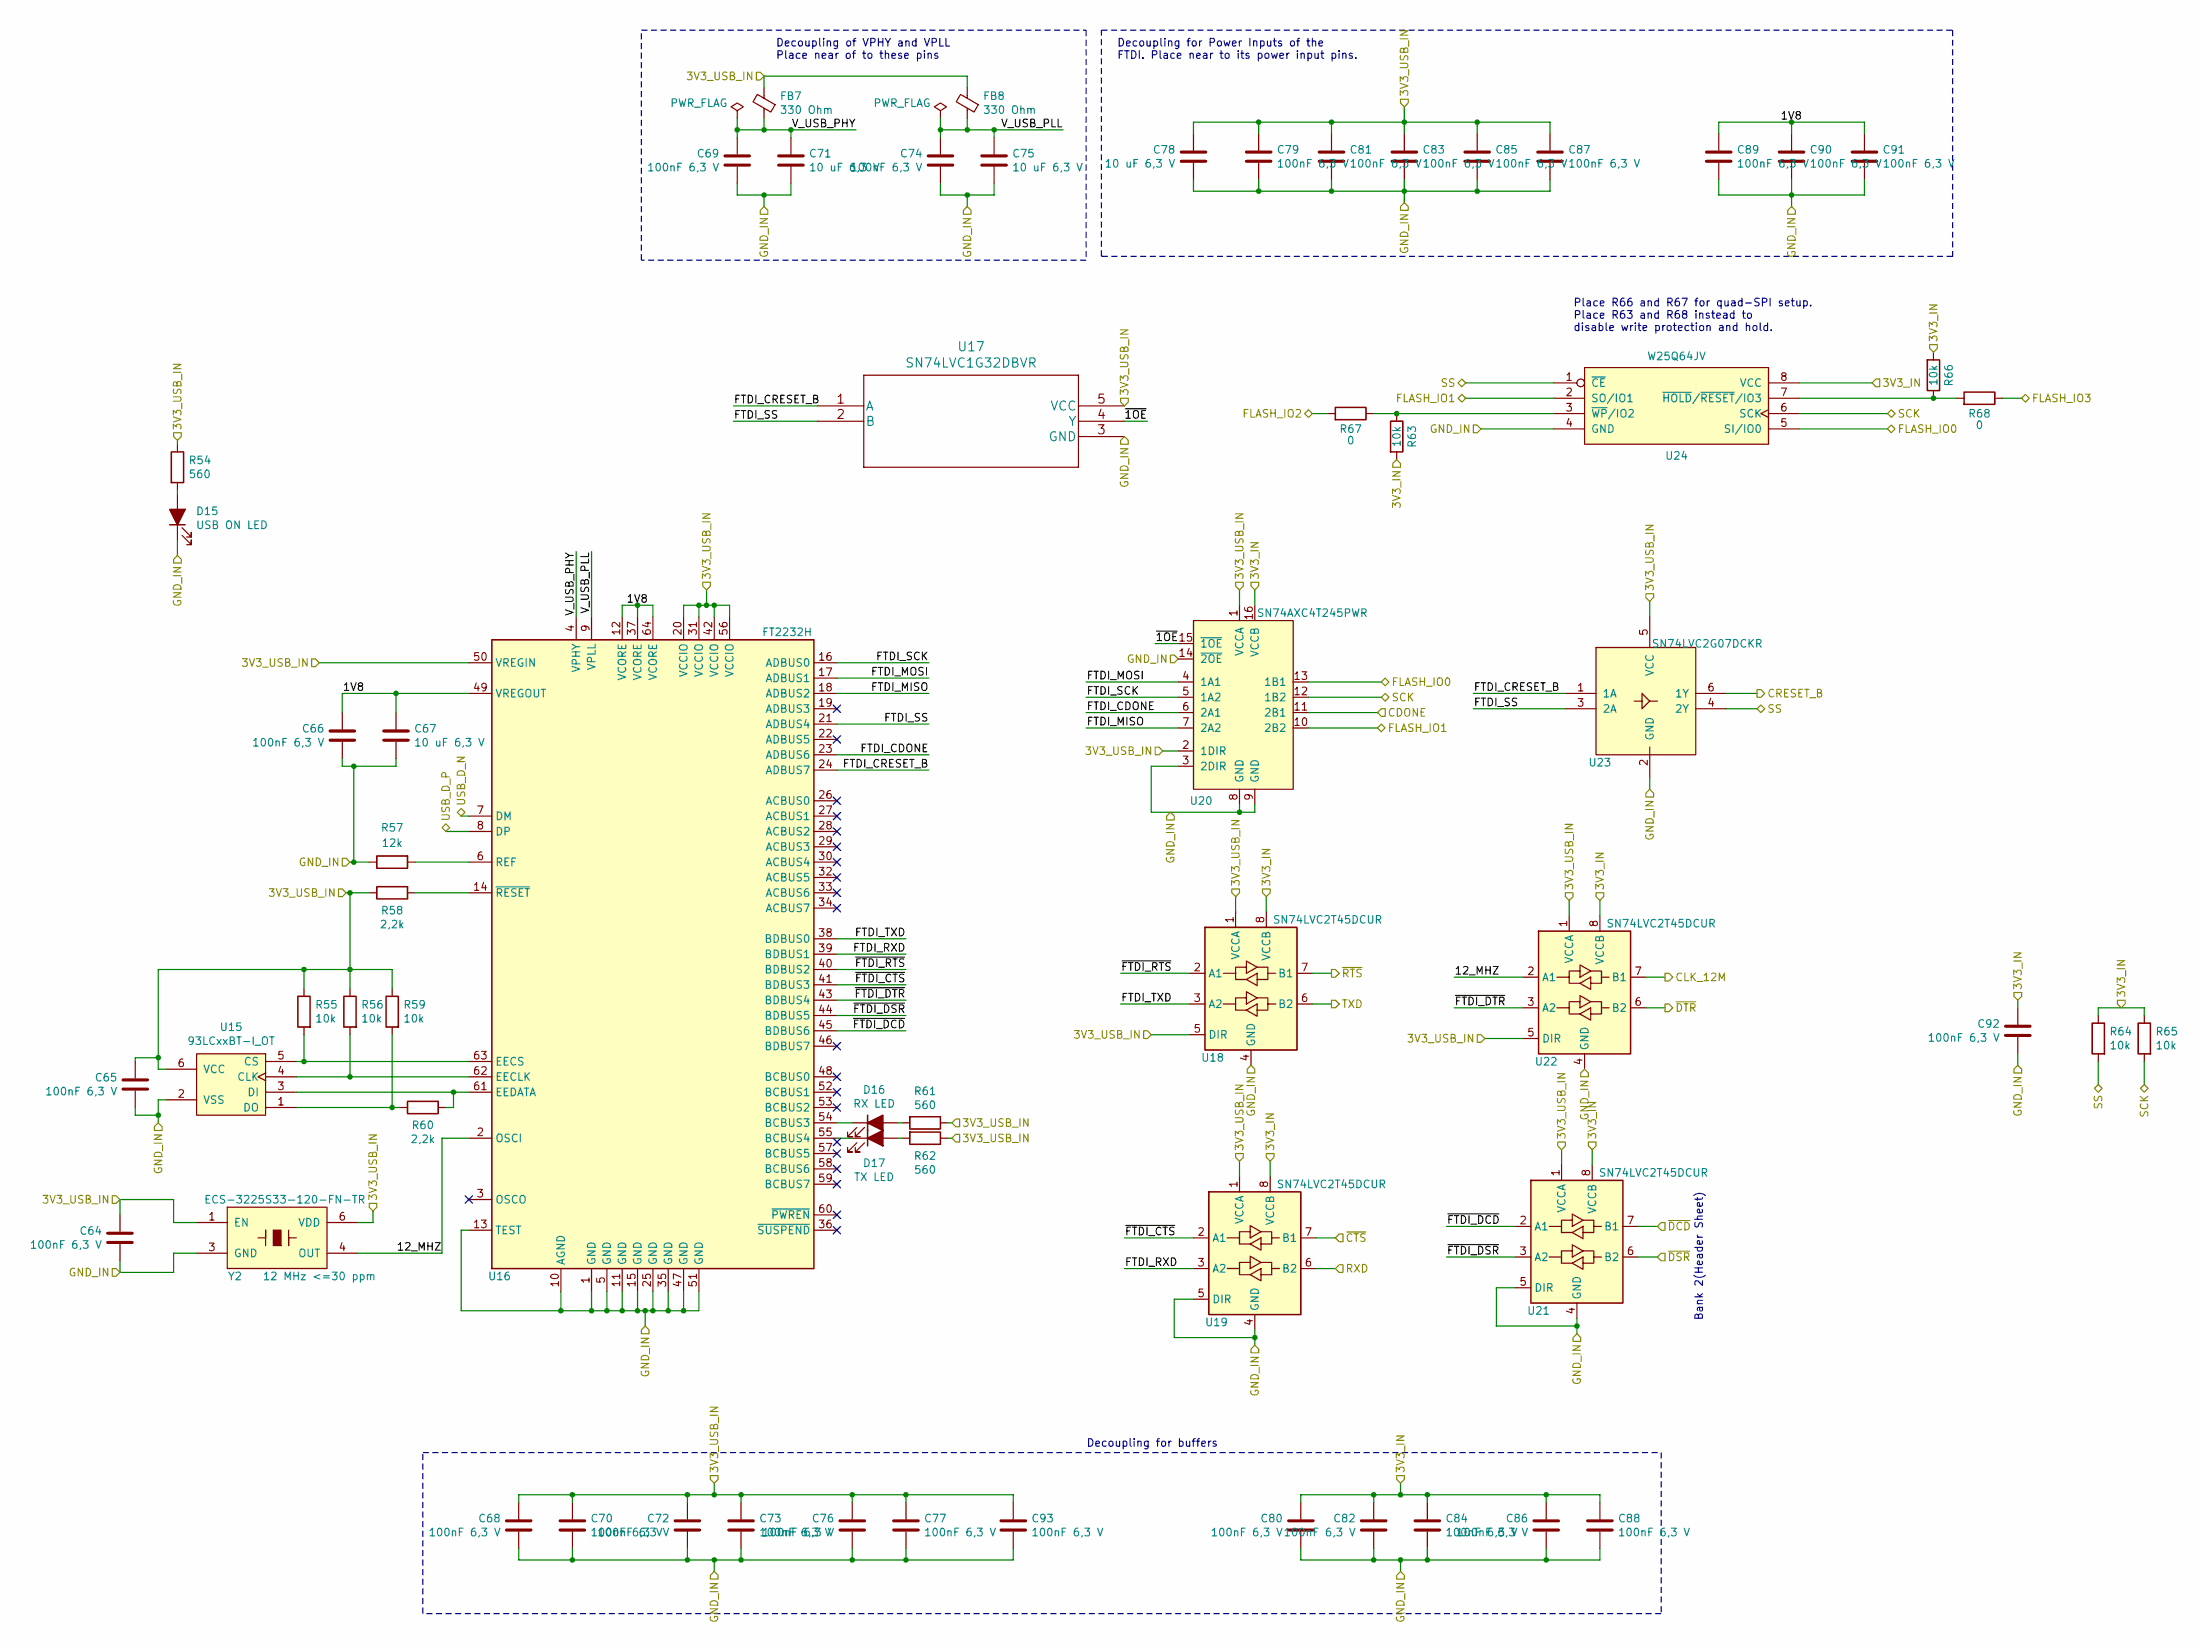
[picture p31: schematic programmer.sch, ICE40HX4K ICEduino educational breakout board]

Parts:
C64, C65, C66, C68, C69, C70, C72, C73, C74, C76, C77, C79, C80, C81, C82, C83, C84, C85, C86, C87, C88, C89, C90, C91, C92, C93: 100nF 6,3 V; C_0603_1608Metric; Mfg Part Num CL10B104KB8NNNC; Digikey 1276-1000-1-ND
C67, C71, C75, C78: 10 uF 6,3 V; C_0603_1608Metric; Mfg Part Num CL10A106MQ8NNNC; Digikey 1276-1119-1-ND
D15: USB ON LED; LED_0603_1608Metric; Mfg Part Num SML-D12U1WT86; Digikey SML-D12U1WT86CT-ND
D16: RX LED; LED_0603_1608Metric; Mfg Part Num SML-D12U1WT86; Digikey SML-D12U1WT86CT-ND
D17: TX LED; LED_0603_1608Metric; Mfg Part Num SML-D12U1WT86; Digikey SML-D12U1WT86CT-ND
FB7, FB8: 330 Ohm; R_0805_2012Metric; Mfg Part Num MPZ2012S331AT000; Digikey 445-1569-1-ND
R54, R61, R62: 560; R_0603_1608Metric; Mfg Part Num RK73B1JTTD561J; Digikey 2019-RK73B1JTTD561JCT-ND
R55, R56, R59, R63, R64, R65, R66: 10k; R_0603_1608Metric; Mfg Part Num RMCF0603JT10K0; Digikey RMCF0603JT10K0CT-ND
R57: 12k; R_0603_1608Metric; Mfg Part Num RC0603JR-0712KL; Digikey 311-12KGRCT-ND
R58, R60: 2,2k; R_0603_1608Metric; Mfg Part Num RC0603FR-072K2L; Digikey 311-2.20KHRCT-ND
R67, R68: 0; R_0603_1608Metric
U15: 93LCxxBT-I_OT; SOT-23-6; Mfg Part Num 93LC56BT-I/OT; Digikey 93LC56BT-I/OTCT-ND
U16: FT2232H; LQFP-64_10x10mm_P0.5mm; Mfg Part Num FT2232HL-REEL; Digikey 768-1024-1-ND
U17: SN74LVC1G32DBVR; SOT-23-5; Mfg Part Num SN74LVC1G32DBVR; Digikey 296-9847-1-ND
U18, U19, U21, U22: SN74LVC2T45DCUR; VSSOP-8_2.4x2.1mm_P0.5mm; Mfg Part Num SN74LVC2T45DCUR; Digikey 296-17014-1-ND
U20: SN74AXC4T245PWR; TSSOP-16_4.4x5mm_P0.65mm; Mfg Part Num SN74AXC4T245PWR; Digikey 296-53472-1-ND
U23: SN74LVC2G07DCKR; SOT-363_SC-70-6; Mfg Part Num SN74LVC2G07DCKR; Digikey 296-13495-1-ND
U24: W25Q64JV; SOIC-8_5.23x5.23mm_P1.27mm; Mfg Part Num W25Q64JVSSIM TR; Digikey W25Q64JVSSIMCT-ND
Y2: ECS-3225S33-120-FN-TR; Y_ECS-3225S_3.2x2.5mm_footprint; Mfg Part Num ECS-3225S33-120-FN-TR; Digikey XC2217CT-ND

Connections:
+3V3: C80.1, C82.1, C84.1, C86.1, C88.1, C92.1, R63.2, R64.1, R65.1, R66.2, U18.8 (VCCB), U19.8 (VCCB), U20.16 (VCCB), U21.8 (VCCB), U22.8 (VCCB), U24.8 (VCC); also elsewhere on the board
+3V3_FTDI: C64.1, C65.1, C68.1, C70.1, C72.1, C73.1, C76.1, C77.1, C78.1, C79.1, C81.1, C83.1, C85.1, C87.1, C93.1, FB7.2, FB8.2, R54.1, R55.1, R56.1, R58.1, R59.1, R61.1, R62.1, U15.6 (VCC), U16.20 (VCCIO), U16.31 (VCCIO), U16.42 (VCCIO), U16.50 (VREGIN), U16.56 (VCCIO), U17.5 (VCC), U18.1 (VCCA), U18.5 (DIR), U19.1 (VCCA), U20.1 (VCCA), U20.2 (1DIR), U21.1 (VCCA), U22.1 (VCCA), U22.5 (DIR), U23.5 (VCC), Y2.1 (EN), Y2.6 (VDD); also elsewhere on the board
/CDONE: U20.11 (2B1); also elsewhere on the board
/CLK_12M: U22.7 (B1); also elsewhere on the board
/CRESET_B: U23.6 (1Y); also elsewhere on the board
/FLASH_IO0: U20.13 (1B1), U24.5 (SI/IO0); also elsewhere on the board
/FLASH_IO1: U20.10 (2B2), U24.2 (SO/IO1); also elsewhere on the board
/FLASH_IO2: R67.2; also elsewhere on the board
/FLASH_IO3: R68.1; also elsewhere on the board
/RXD: U19.6 (B2); also elsewhere on the board
/SCK: R65.2, U20.12 (1B2), U24.6 (SCK); also elsewhere on the board
/SS: R64.2, U23.4 (2Y), U24.1 (~CE~); also elsewhere on the board
/TXD: U18.6 (B2); also elsewhere on the board
/USB_D_N: U16.7 (DM); also elsewhere on the board
/USB_D_P: U16.8 (DP); also elsewhere on the board
/USB_PROGRAMMER/1V8: C66.1, C67.1, C89.1, C90.1, C91.1, U16.12 (VCORE), U16.37 (VCORE), U16.49 (VREGOUT), U16.64 (VCORE)
/USB_PROGRAMMER/12_MHZ: U16.2 (OSCI), U22.2 (A1), Y2.4 (OUT)
/USB_PROGRAMMER/FTDI_CDONE: U16.23 (ADBUS6), U20.6 (2A1)
/USB_PROGRAMMER/FTDI_CRESET_B: U16.24 (ADBUS7), U17.1 (A), U23.1 (1A)
/USB_PROGRAMMER/FTDI_MISO: U16.18 (ADBUS2), U20.7 (2A2)
/USB_PROGRAMMER/FTDI_MOSI: U16.17 (ADBUS1), U20.4 (1A1)
/USB_PROGRAMMER/FTDI_RXD: U16.39 (BDBUS1), U19.3 (A2)
/USB_PROGRAMMER/FTDI_SCK: U16.16 (ADBUS0), U20.5 (1A2)
/USB_PROGRAMMER/FTDI_SS: U16.21 (ADBUS4), U17.2 (B), U23.3 (2A)
/USB_PROGRAMMER/FTDI_TXD: U16.38 (BDBUS0), U18.3 (A2)
/USB_PROGRAMMER/V_USB_PHY: C69.1, C71.1, FB7.1, U16.4 (VPHY)
/USB_PROGRAMMER/V_USB_PLL: C74.1, C75.1, FB8.1, U16.9 (VPLL)
/USB_PROGRAMMER/~1OE~: U17.4 (Y), U20.15 (~1OE~)
/USB_PROGRAMMER/~FTDI_CTS~: U16.41 (BDBUS3), U19.2 (A1)
/USB_PROGRAMMER/~FTDI_DCD~: U16.45 (BDBUS6), U21.2 (A1)
/USB_PROGRAMMER/~FTDI_DSR~: U16.44 (BDBUS5), U21.3 (A2)
/USB_PROGRAMMER/~FTDI_DTR~: U16.43 (BDBUS4), U22.3 (A2)
/USB_PROGRAMMER/~FTDI_RTS~: U16.40 (BDBUS2), U18.2 (A1)
/~CTS~: U19.7 (B1); also elsewhere on the board
/~DCD~: U21.7 (B1); also elsewhere on the board
/~DSR~: U21.6 (B2); also elsewhere on the board
/~DTR~: U22.6 (B2); also elsewhere on the board
/~RTS~: U18.7 (B1); also elsewhere on the board
GND: C64.2, C65.2, C66.2, C67.2, C68.2, C69.2, C70.2, C71.2, C72.2, C73.2, C74.2, C75.2, C76.2, C77.2, C78.2, C79.2, C80.2, C81.2, C82.2, C83.2, C84.2, C85.2, C86.2, C87.2, C88.2, C89.2, C90.2, C91.2, C92.2, C93.2, D15.1 (K), R57.1, U15.2 (VSS), U16.1 (GND), U16.5 (GND), U16.10 (AGND), U16.11 (GND), U16.13 (TEST), U16.15 (GND), U16.25 (GND), U16.35 (GND), U16.47 (GND), U16.51 (GND), U17.3 (GND), U18.4 (GND), U19.4 (GND), U19.5 (DIR), U20.3 (2DIR), U20.8 (GND), U20.9 (GND), U20.14 (~2OE~), U21.4 (GND), U21.5 (DIR), U22.4 (GND), U23.2 (GND), U24.4 (GND), Y2.3 (GND); also elsewhere on the board
unnamed: D15.2 (A), R54.2
unnamed: D16.1 (K), U16.54 (BCBUS3)
unnamed: D16.2 (A), R61.2
unnamed: D17.1 (K), U16.55 (BCBUS4)
unnamed: D17.2 (A), R62.2
unnamed: R55.2, U15.5 (CS), U16.63 (EECS)
unnamed: R56.2, U15.4 (CLK), U16.62 (EECLK)
unnamed: R57.2, U16.6 (REF)
unnamed: R58.2, U16.14 (~RESET)
unnamed: R59.2, R60.1, U15.1 (DO)
unnamed: R60.2, U15.3 (DI), U16.61 (EEDATA)
unnamed: R63.1, R67.1, U24.3 (~WP~/IO2)
unnamed: R66.1, R68.2, U24.7 (~HOLD~/~RESET~/IO3)

Notes on the sheet:
Decoupling of VPHY and VPLL Place near of to these pins
Bank 2(Header Sheet)
Decoupling for Power Inputs of the FTDI. Place near to its power input pins.
Decoupling for buffers
Place R66 and R67 for quad-SPI setup. Place R63 and R68 instead to disable write protection and hold.

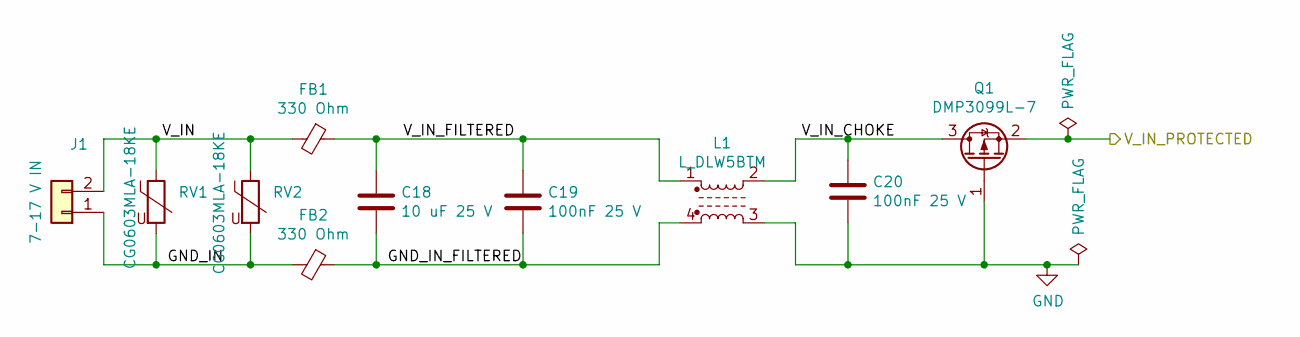
[picture p32: schematic 7to17vin_protection.sch, ICE40HX4K ICEduino educational breakout board]

Parts:
C18: 10 uF 25 V; C_0805_2012Metric; Mfg Part Num CL21A106KAYNNNE; Digikey 1276-2891-1-ND
C19, C20: 100nF 25 V; C_0603_1608Metric; Mfg Part Num CL10B104KB8NNNC; Digikey 1276-1000-1-ND
FB1, FB2: 330 Ohm; R_0805_2012Metric; Mfg Part Num MPZ2012S331AT000; Digikey 445-1569-1-ND
J1: 7-17 V IN; TerminalBlock_bornier-2_P5.08mm; Mfg Part Num TB007-508-02BE; Digikey 102-6203-ND
L1: L_DLW5BTM; L_Murata_DLW5BTM_5.00x5.00mm_footprint; Mfg Part Num DLW5BTM251SQ2L; Digikey 490-11111-1-ND
Q1: DMP3099L-7; SOT-23; Mfg Part Num DMP3099L-7; Digikey DMP3099L-7DICT-ND
RV1, RV2: CG0603MLA-18KE; R_0603_1608Metric; Mfg Part Num CG0603MLA-18KE; Digikey CG0603MLA-18KECT-ND

Connections:
/Power/7-17VIN_PROTECTION/GND_IN: FB2.2, J1.1, RV1.2, RV2.2
/Power/7-17VIN_PROTECTION/GND_IN_FILTERED: C18.2, C19.2, FB2.1, L1.4
/Power/7-17VIN_PROTECTION/V_IN: FB1.2, J1.2, RV1.1, RV2.1
/Power/7-17VIN_PROTECTION/V_IN_CHOKE: C20.1, L1.2, Q1.3 (D)
/Power/7-17VIN_PROTECTION/V_IN_FILTERED: C18.1, C19.1, FB1.1, L1.1
/V_IN_PROTECTED: Q1.2 (S); also elsewhere on the board
GND: C20.2, L1.3, Q1.1 (G); also elsewhere on the board

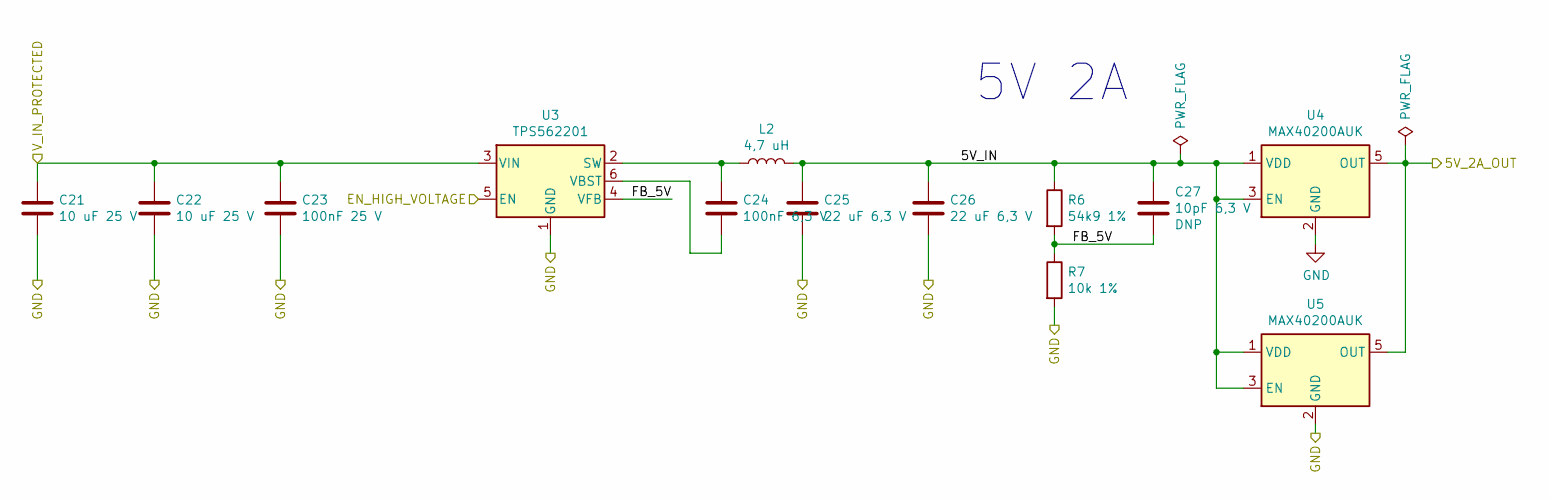
[picture p33: schematic 7to17vin_5v_regulator.sch, ICE40HX4K ICEduino educational breakout board]

Parts:
C21, C22: 10 uF 25 V; C_0805_2012Metric; Mfg Part Num CL21A106KAYNNNE; Digikey 1276-2891-1-ND
C23: 100nF 25 V; C_0603_1608Metric; Mfg Part Num CL10B104KB8NNNC; Digikey 1276-1000-1-ND
C24: 100nF 6,3 V; C_0603_1608Metric; Mfg Part Num CL10B104KB8NNNC; Digikey 1276-1000-1-ND
C25, C26: 22 uF 6,3 V; C_0603_1608Metric; Mfg Part Num GRM188R60J226MEA0D; Digikey 490-7611-1-ND
C27: 10pF 6,3 V; C_0603_1608Metric; Mfg Part Num CL10C100JB8NNNC; Digikey 1276-1027-1-ND
L2: 4,7 uH; L_Taiyo-Yuden_NR-50xx; Mfg Part Num NR5040T4R7N; Digikey 587-2373-1-ND
R6: 54k9 1%; R_0603_1608Metric; Mfg Part Num RC0603FR-0754K9L; Digikey 311-54.9KHRCT-ND
R7: 10k 1%; R_0603_1608Metric; Mfg Part Num RC0603FR-0710KL; Digikey 311-10.0KHRCT-ND
U3: TPS562201; SOT-23-6; Mfg Part Num TPS562201DDCR; Digikey 296-44397-1-ND
U4, U5: MAX40200AUK; SOT-23-5; Mfg Part Num MAX40200AUK+T; Digikey MAX40200AUK+TCT-ND

Connections:
+5V: U4.5 (OUT), U5.5 (OUT); also elsewhere on the board
/Power/7-17VIN-5V_REGULATOR/5V_IN: C25.1, C26.1, C27.1, L2.2, R6.1, U4.1 (VDD), U4.3 (EN), U5.1 (VDD), U5.3 (EN)
/Power/7-17VIN-5V_REGULATOR/FB_5V: C27.2, R6.2, R7.1, U3.4 (VFB)
/Power/EN_HIGH_VOLTAGE: U3.5 (EN); also elsewhere on the board
/V_IN_PROTECTED: C21.1, C22.1, C23.1, U3.3 (VIN); also elsewhere on the board
GND: C21.2, C22.2, C23.2, C25.2, C26.2, R7.2, U3.1 (GND), U4.2 (GND), U5.2 (GND); also elsewhere on the board
unnamed: C24.1, L2.1, U3.2 (SW)
unnamed: C24.2, U3.6 (VBST)

Notes on the sheet:
5V 2A

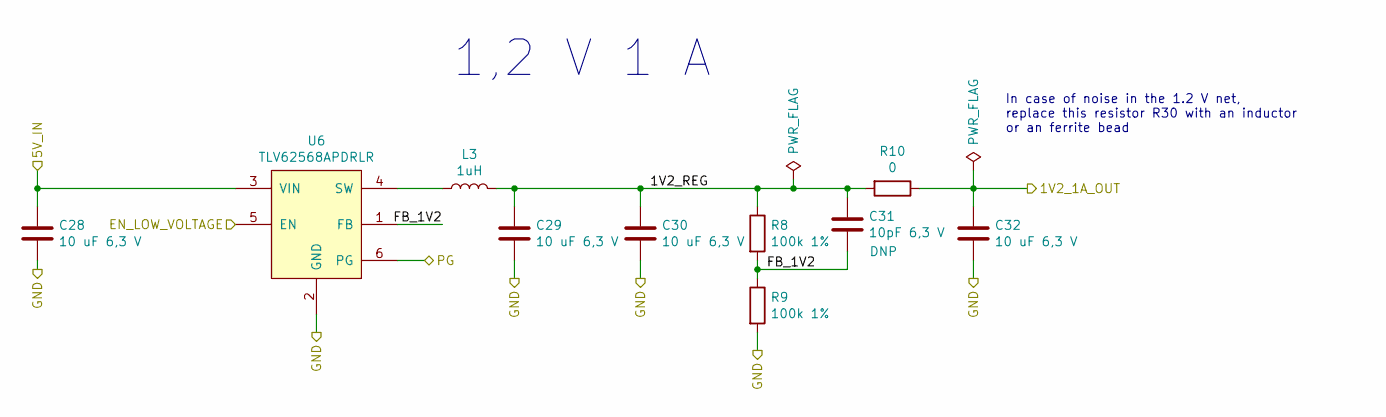
[picture p34: schematic 5vto1v2_regulator.sch, ICE40HX4K ICEduino educational breakout board]

Parts:
C28, C29, C30, C32: 10 uF 6,3 V; C_0603_1608Metric; Mfg Part Num CL10A106MQ8NNNC; Digikey 1276-1119-1-ND
C31: 10pF 6,3 V; C_0603_1608Metric; Mfg Part Num CL10C100JB8NNNC; Digikey 1276-1027-1-ND
L3: 1uH; L_1008_2520Metric_2.5x2mm_footprint; Mfg Part Num MAMK2520T1R0M; Digikey 587-3225-1-ND
R8, R9: 100k 1%; R_0603_1608Metric; Mfg Part Num RC0603FR-07100KL; Digikey 311-100KHRCT-ND
R10: 0; R_0805_2012Metric; Mfg Part Num RC0805JR-070RL; Digikey 311-0.0ARCT-ND
U6: TLV62568APDRLR; Texas_DRL_SOT-563_1.6x1.6mm_0.5mm-pitch_footprint; Mfg Part Num TLV62568APDRLR; Digikey 296-51691-1-ND

Connections:
+1V2: C32.1, R10.1; also elsewhere on the board
+5V: C28.1, U6.3 (VIN); also elsewhere on the board
/CRESET_B: U6.6 (PG); also elsewhere on the board
/Power/5V_1V2_REGULATOR/1V2_REG: C29.1, C30.1, C31.1, L3.2, R8.1, R10.2
/Power/5V_1V2_REGULATOR/FB_1V2: C31.2, R8.2, R9.1, U6.1 (FB)
/Power/EN_LOW_VOLTAGE: U6.5 (EN); also elsewhere on the board
GND: C28.2, C29.2, C30.2, C32.2, R9.2, U6.2 (GND); also elsewhere on the board
unnamed: L3.1, U6.4 (SW)

Notes on the sheet:
In case of noise in the 1.2 V net, replace this resistor R30 with an inductor or an ferrite bead
1,2 V 1 A

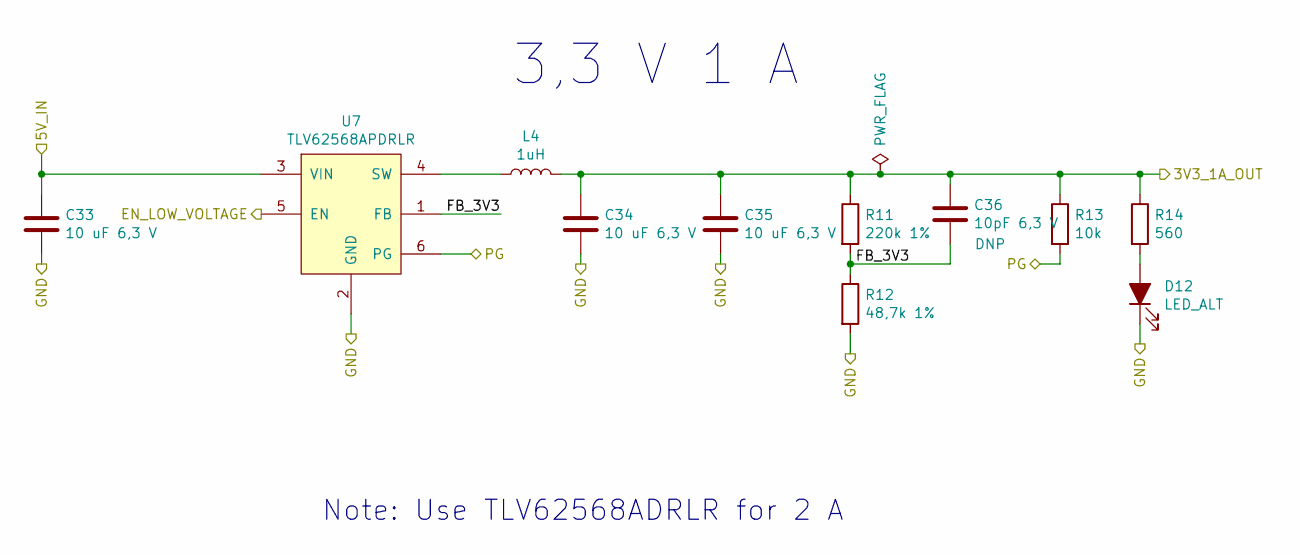
[picture p35: schematic 5vto3v3_regulator.sch, ICE40HX4K ICEduino educational breakout board]

Parts:
C33, C34, C35: 10 uF 6,3 V; C_0603_1608Metric; Mfg Part Num CL10A106MQ8NNNC; Digikey 1276-1119-1-ND
C36: 10pF 6,3 V; C_0603_1608Metric; Mfg Part Num CL10C100JB8NNNC; Digikey 1276-1027-1-ND
D12: LED_ALT; LED_0603_1608Metric; Mfg Part Num SML-D12U1WT86; Digikey SML-D12U1WT86CT-ND
L4: 1uH; L_1008_2520Metric_2.5x2mm_footprint; Mfg Part Num MAMK2520T1R0M; Digikey 587-3225-1-ND
R11: 220k 1%; R_0603_1608Metric; Mfg Part Num RC0603FR-07220KL; Digikey 311-220KHRCT-ND
R12: 48,7k 1%; R_0603_1608Metric; Mfg Part Num RC0603FR-0748K7L; Digikey 311-48.7KHRCT-ND
R13: 10k; R_0603_1608Metric; Mfg Part Num RMCF0603JT10K0; Digikey RMCF0603JT10K0CT-ND
R14: 560; R_0603_1608Metric; Mfg Part Num RK73B1JTTD561J; Digikey 2019-RK73B1JTTD561JCT-ND
U7: TLV62568APDRLR; Texas_DRL_SOT-563_1.6x1.6mm_0.5mm-pitch_footprint; Mfg Part Num TLV62568APDRLR; Digikey 296-51691-1-ND

Connections:
+3V3: C34.1, C35.1, C36.1, L4.2, R11.1, R13.1, R14.1; also elsewhere on the board
+5V: C33.1, U7.3 (VIN); also elsewhere on the board
/CRESET_B: R13.2, U7.6 (PG); also elsewhere on the board
/Power/5V_3V3_REGULATOR/FB_3V3: C36.2, R11.2, R12.1, U7.1 (FB)
/Power/EN_LOW_VOLTAGE: U7.5 (EN); also elsewhere on the board
GND: C33.2, C34.2, C35.2, D12.1 (K), R12.2, U7.2 (GND); also elsewhere on the board
unnamed: D12.2 (A), R14.2
unnamed: L4.1, U7.4 (SW)

Notes on the sheet:
3,3 V 1 A
Note: Use TLV62568ADRLR for 2 A

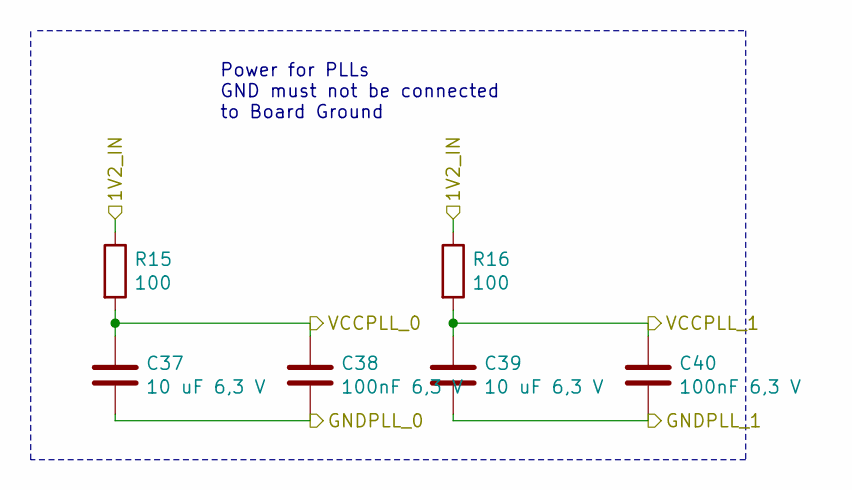
[picture p36: schematic pll_power.sch, ICE40HX4K ICEduino educational breakout board]

Parts:
C37, C39: 10 uF 6,3 V; C_0603_1608Metric; Mfg Part Num CL10A106MQ8NNNC; Digikey 1276-1119-1-ND
C38, C40: 100nF 6,3 V; C_0603_1608Metric; Mfg Part Num CL10B104KB8NNNC; Digikey 1276-1000-1-ND
R15, R16: 100; R_0603_1608Metric; Mfg Part Num RMCF0603FT100R; Digikey RMCF0603FT100RCT-ND

Connections:
+1V2: R15.1, R16.1; also elsewhere on the board
/GNDPLL_0: C37.2, C38.2; also elsewhere on the board
/GNDPLL_1: C39.2, C40.2; also elsewhere on the board
/VCCPLL_0: C37.1, C38.1, R15.2; also elsewhere on the board
/VCCPLL_1: C39.1, C40.1, R16.2; also elsewhere on the board

Notes on the sheet:
Power for PLLs GND must not be connected to Board Ground

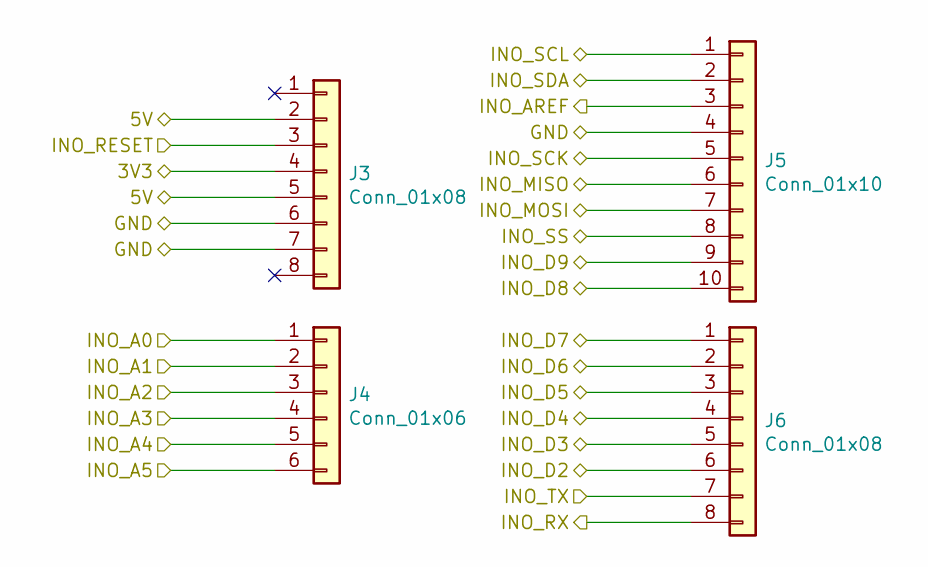
[picture p37: schematic arduino_header.sch, ICE40HX4K ICEduino educational breakout board]

Parts:
J3, J6: Conn_01x08; PinSocket_1x08_P2.54mm_Vertical; Mfg Part Num PPPC081LFBN-RC; Digikey S7041-ND
J4: Conn_01x06; PinSocket_1x06_P2.54mm_Vertical; Mfg Part Num PPPC061LFBN-RC; Digikey S7039-ND
J5: Conn_01x10; PinSocket_1x10_P2.54mm_Vertical; Mfg Part Num 61301011821; Digikey 732-2859-ND

Connections:
+5V: J3.2, J3.5; also elsewhere on the board
/HEADER/INO_3V3: J3.4; also elsewhere on the board
/HEADER/INO_A0: J4.1; also elsewhere on the board
/HEADER/INO_A1: J4.2; also elsewhere on the board
/HEADER/INO_A2: J4.3; also elsewhere on the board
/HEADER/INO_A3: J4.4; also elsewhere on the board
/HEADER/INO_A4: J4.5; also elsewhere on the board
/HEADER/INO_A5: J4.6; also elsewhere on the board
/HEADER/INO_AREF: J5.3; also elsewhere on the board
/HEADER/INO_D2: J6.6; also elsewhere on the board
/HEADER/INO_D3: J6.5; also elsewhere on the board
/HEADER/INO_D4: J6.4; also elsewhere on the board
/HEADER/INO_D5: J6.3; also elsewhere on the board
/HEADER/INO_D6: J6.2; also elsewhere on the board
/HEADER/INO_D7: J6.1; also elsewhere on the board
/HEADER/INO_D8: J5.10; also elsewhere on the board
/HEADER/INO_D9: J5.9; also elsewhere on the board
/HEADER/INO_MISO: J5.6; also elsewhere on the board
/HEADER/INO_MOSI: J5.7; also elsewhere on the board
/HEADER/INO_RX: J6.8; also elsewhere on the board
/HEADER/INO_SCK: J5.5; also elsewhere on the board
/HEADER/INO_SCL: J5.1; also elsewhere on the board
/HEADER/INO_SDA: J5.2; also elsewhere on the board
/HEADER/INO_SS: J5.8; also elsewhere on the board
/HEADER/INO_TX: J6.7; also elsewhere on the board
/INO_RESET: J3.3; also elsewhere on the board
GND: J3.6, J3.7, J5.4; also elsewhere on the board

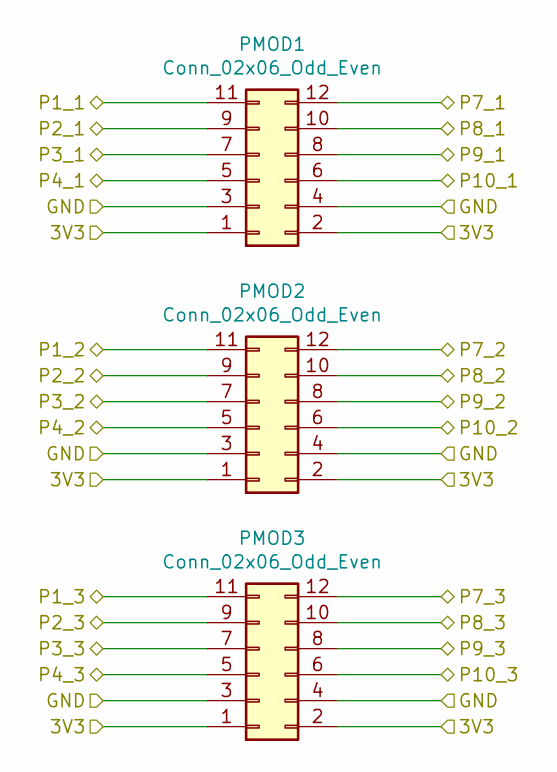
[picture p38: schematic pmod_header.sch, ICE40HX4K ICEduino educational breakout board]

Parts:
PMOD1, PMOD2, PMOD3: Conn_02x06_Odd_Even; PinSocket_2x06_P2.54mm_Horizontal; Mfg Part Num PPPC062LJBN-RC; Digikey S5559-ND

Connections:
/HEADER/PMOD_3V3: PMOD1.1, PMOD1.2, PMOD2.1, PMOD2.2, PMOD3.1, PMOD3.2; also elsewhere on the board
/P1_1: PMOD1.11; also elsewhere on the board
/P1_2: PMOD2.11; also elsewhere on the board
/P1_3: PMOD3.11; also elsewhere on the board
/P2_1: PMOD1.9; also elsewhere on the board
/P2_2: PMOD2.9; also elsewhere on the board
/P2_3: PMOD3.9; also elsewhere on the board
/P3_1: PMOD1.7; also elsewhere on the board
/P3_2: PMOD2.7; also elsewhere on the board
/P3_3: PMOD3.7; also elsewhere on the board
/P4_1: PMOD1.5; also elsewhere on the board
/P4_2: PMOD2.5; also elsewhere on the board
/P4_3: PMOD3.5; also elsewhere on the board
/P7_1: PMOD1.12; also elsewhere on the board
/P7_2: PMOD2.12; also elsewhere on the board
/P7_3: PMOD3.12; also elsewhere on the board
/P8_1: PMOD1.10; also elsewhere on the board
/P8_2: PMOD2.10; also elsewhere on the board
/P8_3: PMOD3.10; also elsewhere on the board
/P9_1: PMOD1.8; also elsewhere on the board
/P9_2: PMOD2.8; also elsewhere on the board
/P9_3: PMOD3.8; also elsewhere on the board
/P10_1: PMOD1.6; also elsewhere on the board
/P10_2: PMOD2.6; also elsewhere on the board
/P10_3: PMOD3.6; also elsewhere on the board
GND: PMOD1.3, PMOD1.4, PMOD2.3, PMOD2.4, PMOD3.3, PMOD3.4; also elsewhere on the board

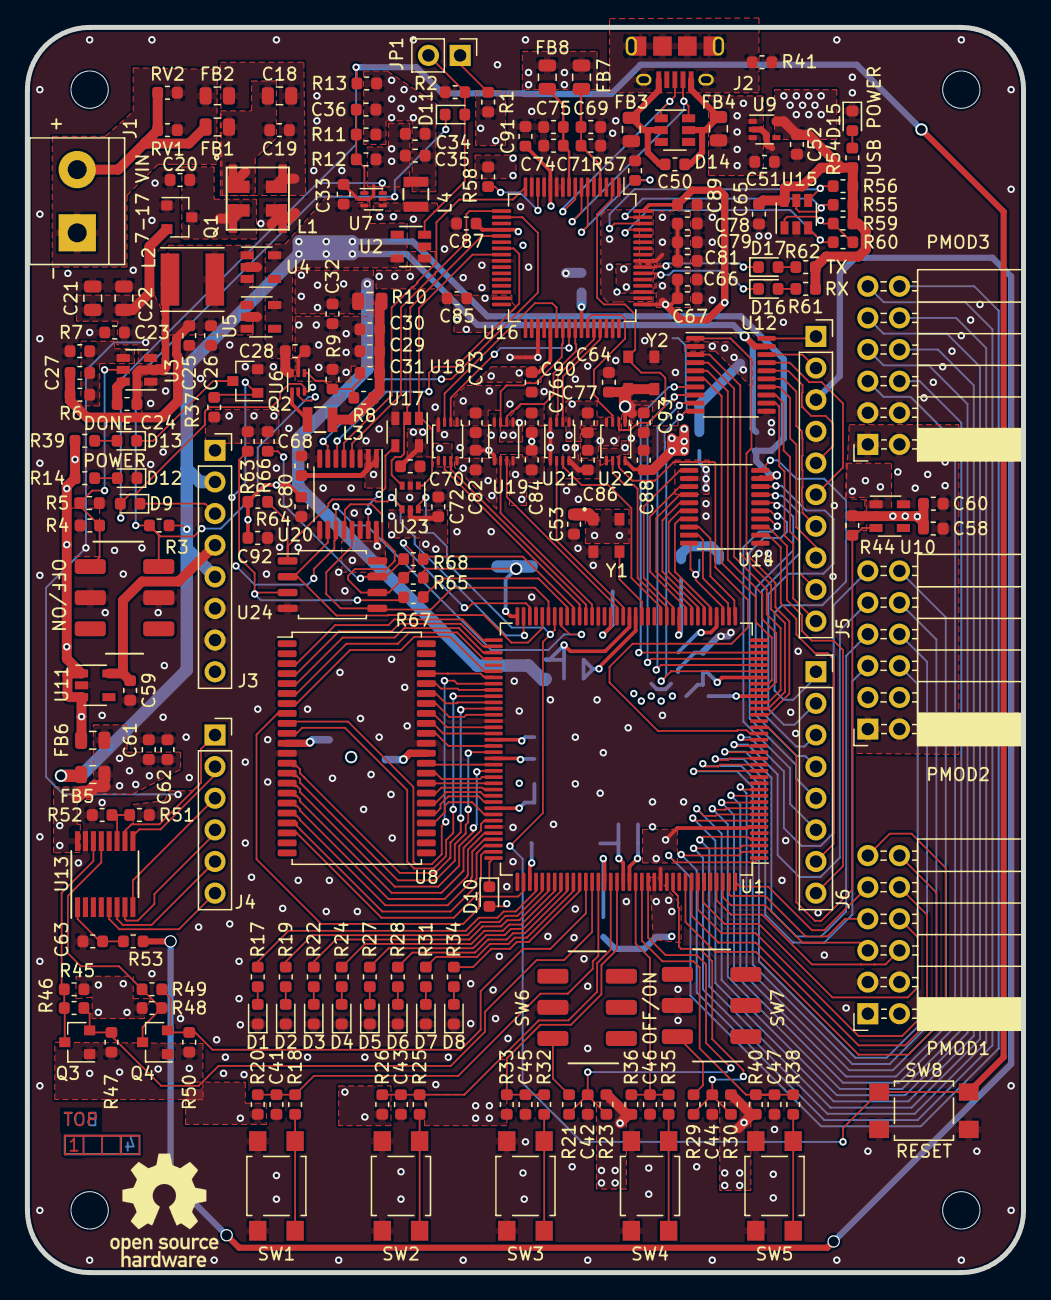
[picture p39: board iceduino.kicad_pcb from above]

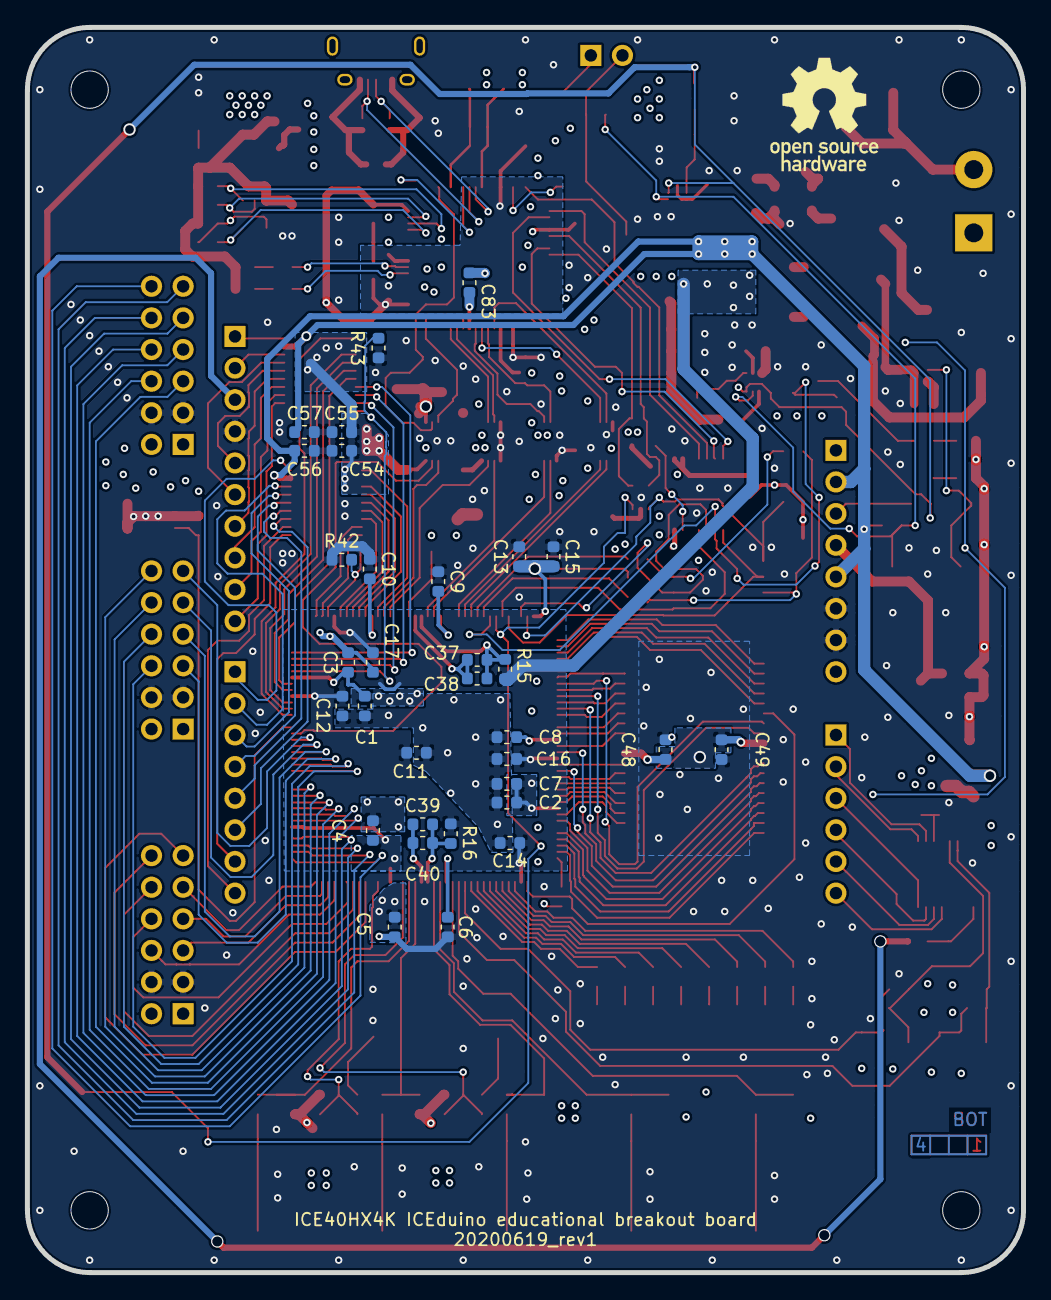
[picture p40: board iceduino.kicad_pcb from below]

Board: 4 copper layers, 80.0 x 100.0 mm, 245 parts (32 on the bottom side), 223 nets.
