MrElliwood/iceduino/(commit log)

2020-05-27 new project
    [iceduino.kicad_pcb, iceduino.sch]
2020-05-27 7-17VIN Power
    [7to17vin_protection.sch, iceduino.sch, power.sch]
2020-05-27 Voltage Regulators
    [5vto1v2_regulator.sch, 5vto3v3_regulator.sch, 7to17vin_5v_regulator.sch, 7to17vin_protection.sch, iceduino.sch, power.sch]
2020-05-27 ui sheet
    [5vto1v2_regulator.sch, 5vto3v3_regulator.sch, 7to17vin_5v_regulator.sch, 7to17vin_protection.sch, iceduino.sch, power.sch, ui.sch]
2020-06-12 Schematic modified (Hierarchy) Bug where SPI was active when creset or ss was low fixed PCB layout started (almost all parts are at position) No parts on the bottom so far Arduino and PMOD header spa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
    [5vto1v2_regulator.sch, 5vto3v3_regulator.sch, 7to17vin_5v_regulator.sch, 7to17vin_protection.sch, arduino_header.sch, header.sch, iceduino.kicad_pcb, iceduino.sch]
2020-06-13 8MBit Flash swapped to a 64MBit one
    [iceduino.kicad_pcb, programmer.sch]
2020-06-15 Added wires for quad-SPI Flash operation
    [iceduino.sch, programmer.sch]
2020-06-15 7-17 VIN Power PIN Header moved to the left for better compatibility with extension boards. Added 0 Ohm resistors for optional desoldering of quad-SPI wires. USB power jumper moved more to the side o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
    [arduino_header.sch, header.sch, iceduino.kicad_pcb, programmer.sch]
2020-06-15 Move of decoupling capacitors from last commit reverted (meant for Arduino Header Level Shifters). Component placement complete.
    [arduino_header.sch, header.sch, iceduino.kicad_pcb]
2020-06-16 FPGA PINs for PMOD reorganized FPGA PINs for Arduino Header reorganized Trace routing partially ready
    [iceduino.kicad_pcb, iceduino.sch]
2020-06-18 Oscillator Footprints bug fixed in the footprint library
2020-06-18 Board design completed Revision 1
    [header.sch, iceduino.kicad_pcb, iceduino.sch]
2020-06-19 Added project description in kicad schematic sheets Added project name and OSHW logo on the board
    [5vto1v2_regulator.sch, 5vto3v3_regulator.sch, 7to17vin_5v_regulator.sch, 7to17vin_protection.sch, arduino_header.sch, header.sch, iceduino.kicad_pcb, iceduino.sch]
2020-06-19 Bigger OSHW logo
    [iceduino.kicad_pcb]
2020-06-19 Power layer was not entirely used
    [iceduino.kicad_pcb]
2020-06-19 Gerber and Drill Files
    [iceduino-B_Cu.gbr, iceduino-B_Mask.gbr, iceduino-B_Paste.gbr, iceduino-B_SilkS.gbr, iceduino-Edge_Cuts.gbr, iceduino-F_Cu.gbr, iceduino-F_Mask.gbr, iceduino-F_Paste.gbr]
2020-06-19 Power layer still wasn't entirely used
    [iceduino.kicad_pcb]
2020-06-19 Bill of materials
    [uart.sch]
2020-06-19 Part specifications added to the VBUS Enable Jumper
    [power.sch]
2020-08-12 Schaltpläne als pdf und svg
